domesticmouse/BufferedMult-SKiDL/prompts/README.md

# Conversation Prompt Archive for `skidl-test`

This directory contains detailed Markdown records capturing user prompts, Antigravity actions, tool executions, modified files, and timestamps across project conversations.

## Index of Conversations

| # | Title | Date / Time | Duration | Turns | Session Link | File |
| :--- | :--- | :--- | :---: | :---: | :---: | :--- |
| 01 | **I want to create a KiKad circuit using skidl. I'd like to buil...** | 2026-10-21 10:46 | 0:26:01 | 5 | `a742ea3b` [↗](conversation://a742ea3b-74c5-468e-a215-c797a4e4c2e3) | [01-i-want-to-create-a-kikad.md](./01-i-want-to-create-a-kikad.md) |
| 02 | **What is required to turn the @[buffered_multiple_bom.xml] into...** | 2026-10-21 11:16 | 0:19:49 | 4 | `af8a35a1` [↗](conversation://af8a35a1-3b6d-492d-a452-7a1e5ba92e80) | [02-what-is-required-to-turn-the.md](./02-what-is-required-to-turn-the.md) |
| 03 | **Please investigate whether JLCPCB has a IDC 2x5 socket availab...** | 2026-10-21 11:35 | 0:06:23 | 2 | `48d9d675` [↗](conversation://48d9d675-2952-4372-af7c-8b1982e387b5) | [03-please-investigate-whether-jlcpcb-has-a.md](./03-please-investigate-whether-jlcpcb-has-a.md) |
| 04 | **How do I layout this PCB in KiCad?** | 2026-10-21 11:44 | 0:36:38 | 3 | `ffb5d563` [↗](conversation://ffb5d563-22b9-4b88-94b1-c5f2bf82ae1d) | [04-how-do-i-layout-this-pcb.md](./04-how-do-i-layout-this-pcb.md) |
| 05 | **Please convert the Eurorack Power connector and bulk capacitor...** | 2026-10-21 12:03 | 0:09:54 | 2 | `15b14db8` [↗](conversation://15b14db8-7712-4b76-9b20-2e3bdbb96513) | [05-please-convert-the-eurorack-power-connector.md](./05-please-convert-the-eurorack-power-connector.md) |
| 06 | **Please update README.md. ** | 2026-10-21 13:20 | 0:01:45 | 2 | `3e06c8ae` [↗](conversation://3e06c8ae-e7f2-4f84-8cf3-1097a7c6791e) | [06-please-update-readmemd-add-a-link.md](./06-please-update-readmemd-add-a-link.md) |
| 07 | **Please review this circuit** | 2026-10-21 19:13 | 0:51:26 | 2 | `48d0b214` [↗](conversation://48d0b214-1fc2-4b9d-b364-0b4bdbb5ccb9) | [07-please-review-this-circuit.md](./07-please-review-this-circuit.md) |
| 08 | **Please check JLCPCB parts for TL074H SOIC** | 2026-10-21 20:03 | 0:10:37 | 3 | `04d450e8` [↗](conversation://04d450e8-f31b-45f6-a022-22b20fb043ac) | [08-please-check-jlcpcb-parts-for-tl074h.md](./08-please-check-jlcpcb-parts-for-tl074h.md) |
| 09 | **Please re-review the circuit, starting with @[DESIGN_REVIEW.md]** | 2026-10-21 20:15 | 0:28:12 | 5 | `2db85ec4` [↗](conversation://2db85ec4-f98f-4e91-9ac5-2ce34bc1bfed) | [09-please-re-review-the-circuit-starting-with.md](./09-please-re-review-the-circuit-starting-with.md) |
| 10 | **Please re-review the circuit, starting with @[/Users/brett/tmp...** | 2026-10-21 20:45 | 0:02:21 | 1 | `d98b5e5b` [↗](conversation://d98b5e5b-7830-4593-824d-9331d7db3262) | [10-please-re-review-the-circuit-starting-with.md](./10-please-re-review-the-circuit-starting-with.md) |
| 11 | **Can you please plan out how to build a eurorack front panel in...** | 2026-10-21 21:06 | 0:35:36 | 6 | `8dd2dc81` [↗](conversation://8dd2dc81-2770-4b0c-b64c-c19b7749be07) | [11-can-you-please-plan-out-how.md](./11-can-you-please-plan-out-how.md) |
| 12 | **Please update the README file** | 2026-10-21 22:14 | 0:01:17 | 1 | `c51f3164` [↗](conversation://c51f3164-342c-4dc3-85b9-59a051bba4fe) | [12-please-update-the-readme-file.md](./12-please-update-the-readme-file.md) |
| 13 | **/agy-brain-explorer Please list all of the conversations in th...** | 2026-10-21 22:27 | 0:09:37 | 3 | `b35c6fdb` [↗](conversation://b35c6fdb-13cd-4e95-881c-4535a604e93c) | [13-please-list-all-of-the-conversations.md](./13-please-list-all-of-the-conversations.md) |
