domesticmouse/BufferedMult-SKiDL/prompts/01-i-want-to-create-a-kikad.md

# Conversation 01: I want to create a KiKad circuit using skidl. I'd like to buil...

- **Session ID**: `a742ea3b-74c5-468e-a215-c797a4e4c2e3` [↗](conversation://a742ea3b-74c5-468e-a215-c797a4e4c2e3)
- **Start Time**: 2026-10-21 10:46:40 AEDT (`2026-10-20 23:46:40 UTC`)
- **End Time**: 2026-10-21 11:12:41 AEDT (`2026-10-21 00:12:41 UTC`)
- **Duration**: 0:26:01
- **Model**: Gemini 4 Argon (Medium)
- **Workspace**: [`/Users/brett/tmp/skidl-test`](file:///Users/brett/tmp/skidl-test)
- **Project**: `skidl-test`

---

## Conversation Turns

### Turn 1: I want to create a KiKad circuit using skidl. I'd like to...

- **Timestamp**: 2026-10-21 10:46:40 AEDT (`2026-10-20 23:46:40 UTC`)
- **Turn Duration**: 2026-10-21 10:50:50 AEDT (`2026-10-20 23:50:50 UTC`)

#### User Prompt

```text
I want to create a KiKad circuit using skidl. I'd like to build a Eurorack Buffered Multiple.
```

#### Antigravity Actions & Summary

Recreating the virtual environment with Python 3.14 so prebuilt binary wheels (such as `h5py`) can be used without compiling from source.

**Key Operations Executed:**

- `read_file`: [`SKILL.md`](file:///Users/brett/tmp/skidl-test/.agents/skills/skidl/SKILL.md)
- `ask_question`: Interactive user selection modal
- `run_command`: `ls -la && which python3`
- `run_command`: `find /Users/brett -maxdepth 3 -name "*venv*" 2>/dev/null; python3 -c "import skidl; pri...`
- `run_command`: `which uv pipx conda pyenv 2>/dev/null || true; /Applications/KiCad/KiCad.app/Contents/F...`
- `run_command`: `/Applications/KiCad/KiCad.app/Contents/MacOS/kicad-cli --version 2>/dev/null || true; u...`
- `run_command`: `ls -la /Users/brett/tmp 2>/dev/null || true; find /Users/brett/.cache/uv -name "*skidl*...`
- `run_command`: `pip3 list 2>/dev/null || true; uv cache dir 2>/dev/null || true`
- `run_command`: `uv venv .venv`
- `run_command`: `uv pip install skidl`
- `read_file`: [`advanced_patterns.md`](file:///Users/brett/tmp/skidl-test/.agents/skills/skidl/references/advanced_patterns.md)
- `run_command`: `uv python list --only-installed`
- `run_command`: `uv venv --python 3.14 .venv`

---

### Turn 2: That was taking too long. Please re-try

- **Timestamp**: 2026-10-21 10:57:31 AEDT (`2026-10-20 23:57:31 UTC`)
- **Turn Duration**: 2026-10-21 11:07:11 AEDT (`2026-10-21 00:07:11 UTC`)

#### User Prompt

```text
That was taking too long. Please re-try
```

#### Antigravity Actions & Summary

I have created and verified the SKiDL circuit for your **Eurorack Buffered Multiple (Dual 1-to-3, Normalized to 1-to-6, SMD)** in [buffered_multiple.py](file:///Users/brett/tmp/skidl-test/buffered_multiple.py). 1. **Power Supply & Protection ([`eurorack_power`](file:///Users/brett/tmp/skidl-test/buffered_multiple.py#L46-L109))**:
   - **Header (`J1`)**: 10-pin (2x5) Eurorack IDC power header (`Connector_IDC:IDC-Header_2x05_P2.54mm_Vertical`) with pins `1–2` on `-12V`, `3–8` on `GND`, and `9–10` on `+12V`.
   - **Reverse-Polarity Protection (`D1`, `D2`)**: `1N5819` / `SS14` Schottky diodes i...

**Key Operations Executed:**

- `run_command`: `uv venv --clear --python 3.14 .venv`
- `run_command`: `uv pip install skidl`
- `run_command`: `.venv/bin/python -c '`
- `read_file`: [`config_.py`](file:///Users/brett/tmp/skidl-test/.venv/lib/python3.14/site-packages/skidl/config_.py)
- `write_file`: [`sitecustomize.py`](file:///Users/brett/tmp/skidl-test/.venv/lib/python3.14/site-packages/sitecustomize.py)
- `write_file`: [`inspect_parts.py`](file:///Users/brett/.gemini/antigravity/brain/a742ea3b-74c5-468e-a215-c797a4e4c2e3/scratch/inspect_parts.py)
- `run_command`: `.venv/bin/python /Users/brett/.gemini/antigravity/brain/a742ea3b-74c5-468e-a215-c797a4e...`
- `run_command`: `ls /Applications/KiCad/KiCad.app/Contents/SharedSupport/footprints/Connector_Audio.pret...`
- `write_file`: [`buffered_multiple.py`](file:///Users/brett/tmp/skidl-test/buffered_multiple.py)
- `run_command`: `.venv/bin/python buffered_multiple.py`
- `edit_file`: [`buffered_multiple.py`](file:///Users/brett/tmp/skidl-test/buffered_multiple.py)
- `run_command`: `ls -la`
- `run_command`: `rm -f inspect_parts.erc inspect_parts.log skidl_REPL.erc skidl_REPL.log && .venv/bin/py...`

---

### Turn 3: Please run `ruff` for linting and formatting the python c...

- **Timestamp**: 2026-10-21 11:06:52 AEDT (`2026-10-21 00:06:52 UTC`)
- **Turn Duration**: 2026-10-21 11:08:46 AEDT (`2026-10-21 00:08:46 UTC`)

#### User Prompt

```text
Please run `ruff` for linting and formatting the python code.
```

#### Antigravity Actions & Summary

`ruff` linting and formatting have been applied across the workspace: - Replaced the wildcard `from skidl import *` in [buffered_multiple.py](file:///Users/brett/tmp/skidl-test/buffered_multiple.py#L41-L53) with explicit imports and set executable permissions (`chmod +x`) to satisfy `EXE001`.
- Fixed and formatted the auto-generated SKiDL backup library [buffered_multiple_sklib.py](file:///Users/brett/tmp/skidl-test/buffered_multiple_sklib.py).
- Verified both `ruff check .` (`All checks passed!`) and `ruff format --check .` (`4 files already formatted`) exit cleanly with 0 issues.

**Key Operations Executed:**

- `run_command`: `which ruff || .venv/bin/ruff --version 2>/dev/null || uv tool run ruff --version 2>/dev...`
- `run_command`: `ruff check buffered_multiple.py && ruff format --check buffered_multiple.py`
- `run_command`: `chmod +x buffered_multiple.py && ruff format buffered_multiple.py && ruff check buffere...`
- `run_command`: `ruff check . && ruff format --check .`
- `read_file`: [`buffered_multiple.py`](file:///Users/brett/tmp/skidl-test/buffered_multiple.py)
- `edit_file`: [`buffered_multiple.py`](file:///Users/brett/tmp/skidl-test/buffered_multiple.py)
- `run_command`: `ruff check --fix . && ruff format . && ruff check . && ruff format --check .`

---

### Turn 4: /agy-customizations please create / update skills based o...

- **Timestamp**: 2026-10-21 11:09:32 AEDT (`2026-10-21 00:09:32 UTC`)
- **Turn Duration**: 2026-10-21 11:11:26 AEDT (`2026-10-21 00:11:26 UTC`)

#### User Prompt

```text
/agy-customizations please create / update skills based on what you learned in this conversation
```

#### Antigravity Actions & Summary

I have updated the workspace `skidl` skill ([SKILL.md](file:///Users/brett/tmp/skidl-test/.agents/skills/skidl/SKILL.md) and [advanced_patterns.md](file:///Users/brett/tmp/skidl-test/.agents/skills/skidl/references/advanced_patterns.md)) with the lessons learned from this session: 1. **Virtual Environment & Prebuilt Wheels ([SKILL.md](file:///Users/brett/tmp/skidl-test/.agents/skills/skidl/SKILL.md#L17-L21))**:
   - Documented using Python 3.12–3.14 (`uv venv --clear --python 3.14 .venv`) to ensure prebuilt `h5py` wheels are available (avoiding source compilation failures on Python 3.15 whe...

**Key Operations Executed:**

- `read_file`: [`SKILL.md`](file:///Users/brett/.gemini/antigravity/builtin/skills/agy-customizations/SKILL.md)
- `read_file`: [`skills.md`](file:///Users/brett/.gemini/antigravity/builtin/skills/agy-customizations/docs/skills.md)
- `read_file`: [`SKILL.md`](file:///Users/brett/tmp/skidl-test/.agents/skills/skidl/SKILL.md)
- `edit_file`: [`SKILL.md`](file:///Users/brett/tmp/skidl-test/.agents/skills/skidl/SKILL.md)
- `edit_file`: [`advanced_patterns.md`](file:///Users/brett/tmp/skidl-test/.agents/skills/skidl/references/advanced_patterns.md)

---

### Turn 5: Please create a README.md for this project

- **Timestamp**: 2026-10-21 11:12:11 AEDT (`2026-10-21 00:12:11 UTC`)
- **Turn Duration**: 2026-10-21 11:12:41 AEDT (`2026-10-21 00:12:41 UTC`)

#### User Prompt

```text
Please create a README.md for this project
```

#### Antigravity Actions & Summary

I have created [README.md](file:///Users/brett/tmp/skidl-test/README.md) for the project. It includes: - **Features & Architecture**: Explanation of the Dual 1-to-3 / cascaded 1-to-6 normalization, op-amp buffering topology, and Eurorack power protection, along with a Mermaid signal-flow diagram.
- **Bill of Materials (BOM)**: Full table of quantities, component values, KiCad 10 symbols, and SMD/THT footprints.
- **Getting Started**: Setup instructions using `uv`, running [buffered_multiple.py](file:///Users/brett/tmp/skidl-test/buffered_multiple.py), and linting/formatting with `ruff`.
- *...

**Key Operations Executed:**

- `write_file`: [`README.md`](file:///Users/brett/tmp/skidl-test/README.md)

---

## Key Files Created / Modified

- [`sitecustomize.py`](file:///Users/brett/tmp/skidl-test/.venv/lib/python3.14/site-packages/sitecustomize.py) - `/Users/brett/tmp/skidl-test/.venv/lib/python3.14/site-packages/sitecustomize.py`
- [`inspect_parts.py`](file:///Users/brett/.gemini/antigravity/brain/a742ea3b-74c5-468e-a215-c797a4e4c2e3/scratch/inspect_parts.py) - `/Users/brett/.gemini/antigravity/brain/a742ea3b-74c5-468e-a215-c797a4e4c2e3/scratch/inspect_parts.py`
- [`buffered_multiple.py`](file:///Users/brett/tmp/skidl-test/buffered_multiple.py) - `/Users/brett/tmp/skidl-test/buffered_multiple.py`
- [`SKILL.md`](file:///Users/brett/tmp/skidl-test/.agents/skills/skidl/SKILL.md) - `/Users/brett/tmp/skidl-test/.agents/skills/skidl/SKILL.md`
- [`advanced_patterns.md`](file:///Users/brett/tmp/skidl-test/.agents/skills/skidl/references/advanced_patterns.md) - `/Users/brett/tmp/skidl-test/.agents/skills/skidl/references/advanced_patterns.md`
- [`README.md`](file:///Users/brett/tmp/skidl-test/README.md) - `/Users/brett/tmp/skidl-test/README.md`
