domesticmouse/BufferedMult-SKiDL/prompts/03-please-investigate-whether-jlcpcb-has-a.md

# Conversation 03: Please investigate whether JLCPCB has a IDC 2x5 socket availab...

- **Session ID**: `48d9d675-2952-4372-af7c-8b1982e387b5` [↗](conversation://48d9d675-2952-4372-af7c-8b1982e387b5)
- **Start Time**: 2026-10-21 11:35:57 AEDT (`2026-10-21 00:35:57 UTC`)
- **End Time**: 2026-10-21 11:42:20 AEDT (`2026-10-21 00:42:20 UTC`)
- **Duration**: 0:06:23
- **Model**: Gemini 4 Argon (Medium)
- **Workspace**: [`/Users/brett/tmp/skidl-test`](file:///Users/brett/tmp/skidl-test)
- **Project**: `skidl-test`

---

## Conversation Turns

### Turn 1: Please investigate whether JLCPCB has a IDC 2x5 socket av...

- **Timestamp**: 2026-10-21 11:35:57 AEDT (`2026-10-21 00:35:57 UTC`)
- **Turn Duration**: 2026-10-21 11:37:31 AEDT (`2026-10-21 00:37:31 UTC`)

#### User Prompt

```text
Please investigate whether JLCPCB has a IDC 2x5 socket available as a SMD part, and if they do, what is the cost.
```

#### Antigravity Actions & Summary

Yes, JLCPCB stocks several SMD 2x5 (10-pin) connectors in their live catalog (queried via [jlcpcb_search.py](file:///Users/brett/tmp/skidl-test/.agents/skills/skidl/scripts/jlcpcb_search.py)). All 2x5 SMD IDC/header parts on JLCPCB are classified as **Extended Parts**, meaning they carry a one-time **~\$3.00 feeder loading fee** per order in addition to the per-unit component cost.

**Key Operations Executed:**

- `read_file`: [`SKILL.md`](file:///Users/brett/tmp/skidl-test/.agents/skills/skidl/SKILL.md)
- `read_file`: [`jlcpcb_bom.md`](file:///Users/brett/tmp/skidl-test/.agents/skills/skidl/references/jlcpcb_bom.md)
- `read_file`: [`jlcpcb_search.py`](file:///Users/brett/tmp/skidl-test/.agents/skills/skidl/scripts/jlcpcb_search.py)
- `run_command`: `python3 .agents/skills/skidl/scripts/jlcpcb_search.py --in-stock-only --limit 15 "IDC 2...`
- `run_command`: `python3 .agents/skills/skidl/scripts/jlcpcb_search.py --in-stock-only --limit 30 "IDC C...`

---

### Turn 2: Please update the circuit to use C41376028 for the eurora...

- **Timestamp**: 2026-10-21 11:40:10 AEDT (`2026-10-21 00:40:10 UTC`)
- **Turn Duration**: 2026-10-21 11:42:20 AEDT (`2026-10-21 00:42:20 UTC`)

#### User Prompt

```text
Please update the circuit to use C41376028 for the eurorack power adapter
```

#### Antigravity Actions & Summary

I have updated the Eurorack power header in [`eurorack_power`](file:///Users/brett/tmp/skidl-test/buffered_multiple.py#L79-L96) to use the SMD 2x5 shrouded IDC connector (`C41376028`) and regenerated all output files:

**Key Operations Executed:**

- `run_command`: `ls -la /Users/brett/tmp/skidl-test`
- `read_file`: [`buffered_multiple.py`](file:///Users/brett/tmp/skidl-test/buffered_multiple.py)
- `read_file`: [`buffered_multiple_jlcpcb_bom.csv`](file:///Users/brett/tmp/skidl-test/buffered_multiple_jlcpcb_bom.csv)
- `read_file`: [`README.md`](file:///Users/brett/tmp/skidl-test/README.md)
- `run_command`: `.venv/bin/python -c '`
- `run_command`: `ls /Applications/KiCad/KiCad.app/Contents/SharedSupport/footprints/Connector_IDC.pretty...`
- `edit_file`: [`buffered_multiple.py`](file:///Users/brett/tmp/skidl-test/buffered_multiple.py)
- `edit_file`: [`README.md`](file:///Users/brett/tmp/skidl-test/README.md)
- `run_command`: `.venv/bin/python buffered_multiple.py && ruff check --fix . && ruff format .`

---

## Key Files Created / Modified

- [`buffered_multiple.py`](file:///Users/brett/tmp/skidl-test/buffered_multiple.py) - `/Users/brett/tmp/skidl-test/buffered_multiple.py`
- [`README.md`](file:///Users/brett/tmp/skidl-test/README.md) - `/Users/brett/tmp/skidl-test/README.md`
