domesticmouse/BufferedMult-SKiDL/prompts/04-how-do-i-layout-this-pcb.md

# Conversation 04: How do I layout this PCB in KiCad?

- **Session ID**: `ffb5d563-22b9-4b88-94b1-c5f2bf82ae1d` [↗](conversation://ffb5d563-22b9-4b88-94b1-c5f2bf82ae1d)
- **Start Time**: 2026-10-21 11:44:09 AEDT (`2026-10-21 00:44:09 UTC`)
- **End Time**: 2026-10-21 12:20:47 AEDT (`2026-10-21 01:20:47 UTC`)
- **Duration**: 0:36:38
- **Model**: Gemini 4 Argon (Medium)
- **Workspace**: [`/Users/brett/tmp/skidl-test`](file:///Users/brett/tmp/skidl-test)
- **Project**: `skidl-test`

---

## Conversation Turns

### Turn 1: How do I layout this PCB in KiCad?

- **Timestamp**: 2026-10-21 11:44:09 AEDT (`2026-10-21 00:44:09 UTC`)
- **Turn Duration**: 2026-10-21 11:44:38 AEDT (`2026-10-21 00:44:38 UTC`)

#### User Prompt

```text
How do I layout this PCB in KiCad?
```

#### Antigravity Actions & Summary

Here is the step-by-step workflow to lay out your Eurorack Buffered Multiple PCB in **KiCad 10** using [buffered_multiple.net](file:///Users/brett/tmp/skidl-test/buffered_multiple.net) (generated by [buffered_multiple.py](file:///Users/brett/tmp/skidl-test/buffered_multiple.py)). ---

**Key Operations Executed:**

- `read_file`: [`SKILL.md`](file:///Users/brett/tmp/skidl-test/.agents/skills/skidl/SKILL.md)
- `run_command`: `ls -la /Users/brett/tmp/skidl-test`
- `read_file`: [`README.md`](file:///Users/brett/tmp/skidl-test/README.md)
- `read_file`: [`buffered_multiple.py`](file:///Users/brett/tmp/skidl-test/buffered_multiple.py)
- `read_file`: [`buffered_multiple_jlcpcb_bom.csv`](file:///Users/brett/tmp/skidl-test/buffered_multiple_jlcpcb_bom.csv)
- `run_command`: `grep -E '\(comp \(ref|\(value|\(footprint' /Users/brett/tmp/skidl-test/buffered_multipl...`
- `read_file`: [`buffered_multiple.net`](file:///Users/brett/tmp/skidl-test/buffered_multiple.net)

---

### Turn 2: Please update this guide for the new parts and write to d...

- **Timestamp**: 2026-10-21 12:15:30 AEDT (`2026-10-21 01:15:30 UTC`)
- **Turn Duration**: 2026-10-21 12:16:49 AEDT (`2026-10-21 01:16:49 UTC`)

#### User Prompt

```text
Please update this guide for the new parts and write to disk as a markdown file
```

#### Antigravity Actions & Summary

I have updated the layout guide for the new through-hole power header (`J1`, `IDC-Header_2x05_P2.54mm_Vertical`) and radial bulk electrolytic capacitors (`C1`, `C2`, `CP_Radial_D5.0mm_P2.00mm` / `ECEA1EKS100`) and saved it to [PCB_LAYOUT_GUIDE.md](file:///Users/brett/tmp/skidl-test/PCB_LAYOUT_GUIDE.md) (and linked it from [README.md](file:///Users/brett/tmp/skidl-test/README.md#L102-L107)).

**Key Operations Executed:**

- `read_file`: [`buffered_multiple.py`](file:///Users/brett/tmp/skidl-test/buffered_multiple.py)
- `read_file`: [`README.md`](file:///Users/brett/tmp/skidl-test/README.md)
- `read_file`: [`buffered_multiple_jlcpcb_bom.csv`](file:///Users/brett/tmp/skidl-test/buffered_multiple_jlcpcb_bom.csv)
- `run_command`: `git status -s && git diff --stat`
- `write_file`: [`PCB_LAYOUT_GUIDE.md`](file:///Users/brett/tmp/skidl-test/PCB_LAYOUT_GUIDE.md)
- `edit_file`: [`README.md`](file:///Users/brett/tmp/skidl-test/README.md)

---

### Turn 3: Please update the layout guide to show the bulk capacitor...

- **Timestamp**: 2026-10-21 12:19:55 AEDT (`2026-10-21 01:19:55 UTC`)
- **Turn Duration**: 2026-10-21 12:20:47 AEDT (`2026-10-21 01:20:47 UTC`)

#### User Prompt

```text
Please update the layout guide to show the bulk capacitors as being front mounted. Everything else looks correct
```

#### Antigravity Actions & Summary

I have updated [PCB_LAYOUT_GUIDE.md](file:///Users/brett/tmp/skidl-test/PCB_LAYOUT_GUIDE.md) so the radial bulk electrolytic capacitors (`C1`, `C2`, `ECEA1EKS100`) are placed on the **front side (`F.Cu`)** alongside the Eurorack jacks (`J2`–`J9`), leaving only `J1` (`EURORACK_PWR_10PIN`) and the 16 SMD components on the back side (`B.Cu`).

**Key Operations Executed:**

- `read_file`: [`PCB_LAYOUT_GUIDE.md`](file:///Users/brett/tmp/skidl-test/PCB_LAYOUT_GUIDE.md)
- `edit_file`: [`PCB_LAYOUT_GUIDE.md`](file:///Users/brett/tmp/skidl-test/PCB_LAYOUT_GUIDE.md)

---

## Key Files Created / Modified

- [`PCB_LAYOUT_GUIDE.md`](file:///Users/brett/tmp/skidl-test/PCB_LAYOUT_GUIDE.md) - `/Users/brett/tmp/skidl-test/PCB_LAYOUT_GUIDE.md`
- [`README.md`](file:///Users/brett/tmp/skidl-test/README.md) - `/Users/brett/tmp/skidl-test/README.md`
