domesticmouse/BufferedMult-SKiDL/prompts/05-please-convert-the-eurorack-power-connector.md

# Conversation 05: Please convert the Eurorack Power connector and bulk capacitor...

- **Session ID**: `15b14db8-7712-4b76-9b20-2e3bdbb96513` [↗](conversation://15b14db8-7712-4b76-9b20-2e3bdbb96513)
- **Start Time**: 2026-10-21 12:03:53 AEDT (`2026-10-21 01:03:53 UTC`)
- **End Time**: 2026-10-21 12:13:47 AEDT (`2026-10-21 01:13:47 UTC`)
- **Duration**: 0:09:54
- **Model**: Gemini 4 Argon (Medium)
- **Workspace**: [`/Users/brett/tmp/skidl-test`](file:///Users/brett/tmp/skidl-test)
- **Project**: `skidl-test`

---

## Conversation Turns

### Turn 1: Please convert the Eurorack Power connector and bulk capa...

- **Timestamp**: 2026-10-21 12:03:53 AEDT (`2026-10-21 01:03:53 UTC`)
- **Turn Duration**: 2026-10-21 12:06:15 AEDT (`2026-10-21 01:06:15 UTC`)

#### User Prompt

```text
Please convert the Eurorack Power connector and bulk capacitors to through hole parts. I don't want them on the JLCPCB BOM.
```

#### Antigravity Actions & Summary

I have converted the Eurorack power connector (`J1`) and the two `10uF` bulk electrolytic capacitors (`C1`, `C2`) to through-hole footprints and excluded them from the JLCPCB BOM: 1. **Through-Hole Footprints & BOM Exclusion in [`eurorack_power`](file:///Users/brett/tmp/skidl-test/buffered_multiple.py#L74-L135)**:
   - **Power Connector (`J1`)**: Updated [`FP_PWR_HEADER_10P`](file:///Users/brett/tmp/skidl-test/buffered_multiple.py#L65) to `Connector_IDC:IDC-Header_2x05_P2.54mm_Vertical` and marked `JLCPCB_Class` as `"Manual THT (DNP for SMT)"`.
   - **Bulk Electrolytic Capacitors (`C1`, `C2...

**Key Operations Executed:**

- `read_file`: [`SKILL.md`](file:///Users/brett/tmp/skidl-test/.agents/skills/skidl/SKILL.md)
- `run_command`: `ls -la /Users/brett/tmp/skidl-test`
- `read_file`: [`buffered_multiple.py`](file:///Users/brett/tmp/skidl-test/buffered_multiple.py)
- `read_file`: [`README.md`](file:///Users/brett/tmp/skidl-test/README.md)
- `read_file`: [`buffered_multiple_jlcpcb_bom.csv`](file:///Users/brett/tmp/skidl-test/buffered_multiple_jlcpcb_bom.csv)
- `read_file`: [`jlcpcb_bom.md`](file:///Users/brett/tmp/skidl-test/.agents/skills/skidl/references/jlcpcb_bom.md)
- `run_command`: `git log -p -n 3`
- `run_command`: `.venv/bin/python -c '`
- `run_command`: `ls /Applications/KiCad/KiCad.app/Contents/SharedSupport/footprints/Connector_IDC.pretty...`
- `run_command`: `git log -p buffered_multiple.py`
- `edit_file`: [`buffered_multiple.py`](file:///Users/brett/tmp/skidl-test/buffered_multiple.py)
- `edit_file`: [`README.md`](file:///Users/brett/tmp/skidl-test/README.md)
- `run_command`: `.venv/bin/python buffered_multiple.py && ruff check --fix . && ruff format .`
- `run_command`: `git status -s && ruff check .`

---

### Turn 2: Please confirm for the bulk capacitors, the footprint is ...

- **Timestamp**: 2026-10-21 12:12:10 AEDT (`2026-10-21 01:12:10 UTC`)
- **Turn Duration**: 2026-10-21 12:13:47 AEDT (`2026-10-21 01:13:47 UTC`)

#### User Prompt

```text
Please confirm for the bulk capacitors, the footprint is usable with https://www.lcsc.com/product-detail/C713347.html
```

#### Antigravity Actions & Summary

Good catch checking the exact part! **`C713347`** is the **Panasonic `ECEA1EKS100`** ($10\,\mu\text{F}$, $25\,\text{V}$, KS Series miniature radial electrolytic capacitor): | Parameter | Panasonic `ECEA1EKS100` (`C713347`) | KiCad `Capacitor_THT:CP_Radial_D5.0mm_P2.00mm` |
| :--- | :--- | :--- |
| **Body Diameter ($\emptyset D$)** | $5.0\,\text{mm}$ ($\times 5.0\,\text{mm}$ height) | $5.0\,\text{mm}$ |
| **Lead Spacing / Pitch ($F$)** | **$2.0\,\text{mm}$** (straight leads) | **$2.00\,\text{mm}$** |
| **Lead Diameter ($\emptyset d$) / Drill** | $0.5\,\text{mm}$ lead | $0.8\,\text{mm}$ drill...

**Key Operations Executed:**

- `search_web`: *""C713347" lcsc capacitor"*
- `search_web`: *""ECEA1EKS100" "lead spacing" OR "pitch" OR "2.0mm" OR "2.5mm""*
- `read_file`: [`CP_Radial_D5.0mm_P2.00mm.kicad_mod`](file:///Applications/KiCad/KiCad.app/Contents/SharedSupport/footprints/Capacitor_THT.pretty/CP_Radial_D5.0mm_P2.00mm.kicad_mod)
- `read_file`: [`CP_Radial_D5.0mm_P2.50mm.kicad_mod`](file:///Applications/KiCad/KiCad.app/Contents/SharedSupport/footprints/Capacitor_THT.pretty/CP_Radial_D5.0mm_P2.50mm.kicad_mod)
- `search_web`: *""ECEA1EKS100" "2.0" OR "2.5" panasonic KS series lead spacing"*
- `edit_file`: [`buffered_multiple.py`](file:///Users/brett/tmp/skidl-test/buffered_multiple.py)
- `edit_file`: [`README.md`](file:///Users/brett/tmp/skidl-test/README.md)
- `run_command`: `.venv/bin/python buffered_multiple.py && ruff check --fix . && ruff format .`

---

## Key Files Created / Modified

- [`buffered_multiple.py`](file:///Users/brett/tmp/skidl-test/buffered_multiple.py) - `/Users/brett/tmp/skidl-test/buffered_multiple.py`
- [`README.md`](file:///Users/brett/tmp/skidl-test/README.md) - `/Users/brett/tmp/skidl-test/README.md`
