domesticmouse/BufferedMult-SKiDL/prompts/06-please-update-readmemd-add-a-link.md

# Conversation 06: Please update README.md. 

- **Session ID**: `3e06c8ae-e7f2-4f84-8cf3-1097a7c6791e` [↗](conversation://3e06c8ae-e7f2-4f84-8cf3-1097a7c6791e)
- **Start Time**: 2026-10-21 13:20:35 AEDT (`2026-10-21 02:20:35 UTC`)
- **End Time**: 2026-10-21 13:22:20 AEDT (`2026-10-21 02:22:20 UTC`)
- **Duration**: 0:01:45
- **Model**: Gemini 4 Argon (Medium)
- **Workspace**: [`/Users/brett/tmp/skidl-test`](file:///Users/brett/tmp/skidl-test)
- **Project**: `skidl-test`

---

## Conversation Turns

### Turn 1: Please update README.md. 

- **Timestamp**: 2026-10-21 13:20:35 AEDT (`2026-10-21 02:20:35 UTC`)
- **Turn Duration**: 2026-10-21 13:21:16 AEDT (`2026-10-21 02:21:16 UTC`)

#### User Prompt

```text
Please update README.md. 
Add a link to https://github.com/domesticmouse/Buffered-Mult. This is a re-implementation of that circuit, without the LED feedback, using SKiDL.
At the bottom, reference the LICENSE, and add that this is not an official Google product.
```

#### Antigravity Actions & Summary

Updated [README.md](file:///Users/brett/tmp/skidl-test/README.md) with:
- A reference and link to [domesticmouse/Buffered-Mult](https://github.com/domesticmouse/Buffered-Mult) in the introduction, noting that this project is a SKiDL re-implementation without the LED feedback circuitry.
- A **License** section at the bottom referencing [LICENSE.txt](file:///Users/brett/tmp/skidl-test/LICENSE.txt) (Apache 2.0) and the disclaimer that this is not an official Google product.

**Key Operations Executed:**

- `read_file`: [`README.md`](file:///Users/brett/tmp/skidl-test/README.md)
- `read_file`: [`LICENSE`](file:///Users/brett/tmp/skidl-test/LICENSE)
- `run_command`: `ls -la /Users/brett/tmp/skidl-test`
- `read_file`: [`LICENSE.txt`](file:///Users/brett/tmp/skidl-test/LICENSE.txt)
- `edit_file`: [`README.md`](file:///Users/brett/tmp/skidl-test/README.md)

---

### Turn 2: Add a note that there is now a PCB in this directory. Del...

- **Timestamp**: 2026-10-21 13:22:01 AEDT (`2026-10-21 02:22:01 UTC`)
- **Turn Duration**: 2026-10-21 13:22:20 AEDT (`2026-10-21 02:22:20 UTC`)

#### User Prompt

```text
Add a note that there is now a PCB in this directory. Delete the instructions for creating a PCB.
```

#### Antigravity Actions & Summary

Updated [README.md](file:///Users/brett/tmp/skidl-test/README.md) to remove the PCB creation instructions and note the included KiCad 10 PCB files ([BufferedMult.kicad_pro](file:///Users/brett/tmp/skidl-test/BufferedMult.kicad_pro) and [BufferedMult.kicad_pcb](file:///Users/brett/tmp/skidl-test/BufferedMult.kicad_pcb)). Would you also like me to delete [PCB_LAYOUT_GUIDE.md](file:///Users/brett/tmp/skidl-test/PCB_LAYOUT_GUIDE.md)?

**Key Operations Executed:**

- `read_file`: [`README.md`](file:///Users/brett/tmp/skidl-test/README.md)
- `run_command`: `git status`
- `edit_file`: [`README.md`](file:///Users/brett/tmp/skidl-test/README.md)

---

## Key Files Created / Modified

- [`README.md`](file:///Users/brett/tmp/skidl-test/README.md) - `/Users/brett/tmp/skidl-test/README.md`
