domesticmouse/BufferedMult-SKiDL/prompts/07-please-review-this-circuit.md

# Conversation 07: Please review this circuit

- **Session ID**: `48d0b214-1fc2-4b9d-b364-0b4bdbb5ccb9` [↗](conversation://48d0b214-1fc2-4b9d-b364-0b4bdbb5ccb9)
- **Start Time**: 2026-10-21 19:13:12 AEDT (`2026-10-21 08:13:12 UTC`)
- **End Time**: 2026-10-21 20:04:38 AEDT (`2026-10-21 09:04:38 UTC`)
- **Duration**: 0:51:26
- **Model**: Gemini 4 Argon (Medium)
- **Workspace**: [`/Users/brett/tmp/skidl-test`](file:///Users/brett/tmp/skidl-test)
- **Project**: `skidl-test`

---

## Conversation Turns

### Turn 1: Please review this circuit

- **Timestamp**: 2026-10-21 19:13:12 AEDT (`2026-10-21 08:13:12 UTC`)
- **Turn Duration**: 2026-10-21 19:17:06 AEDT (`2026-10-21 08:17:06 UTC`)

#### User Prompt

```text
Please review this circuit
```

#### Antigravity Actions & Summary

**Verdict: NOT READY FOR FABRICATION (2 Critical PCB Layout / DRC Open-Circuit Bugs)** While the SKiDL circuit definition ([buffered_multiple.py](file:///Users/brett/tmp/skidl-test/buffered_multiple.py)) and netlist ([buffered_multiple.net](file:///Users/brett/tmp/skidl-test/buffered_multiple.net)) are electrically sound and pass ERC with zero errors, the routed PCB ([BufferedMult.kicad_pcb](file:///Users/brett/tmp/skidl-test/BufferedMult.kicad_pcb)) and exported manufacturing archive ([production/BufferedMult.zip](file:///Users/brett/tmp/skidl-test/production/BufferedMult.zip)) contain **t...

**Key Operations Executed:**

- `run_command`: `ls -la /Users/brett/tmp/skidl-test`
- `read_file`: [`SKILL.md`](file:///Users/brett/tmp/skidl-test/.agents/skills/skidl/SKILL.md)
- `read_file`: [`SKILL.md`](file:///Users/brett/tmp/skidl-test/.agents/skills/kicad/SKILL.md)
- `read_file`: [`buffered_multiple.py`](file:///Users/brett/tmp/skidl-test/buffered_multiple.py)
- `read_file`: [`README.md`](file:///Users/brett/tmp/skidl-test/README.md)
- `read_file`: [`PCB_LAYOUT_GUIDE.md`](file:///Users/brett/tmp/skidl-test/PCB_LAYOUT_GUIDE.md)
- `read_file`: [`report-generation.md`](file:///Users/brett/tmp/skidl-test/.agents/skills/kicad/references/report-generation.md)
- `read_file`: [`SKILL.md`](file:///Users/brett/tmp/skidl-test/.agents/skills/emc/SKILL.md)
- `read_file`: [`SKILL.md`](file:///Users/brett/tmp/skidl-test/.agents/skills/spice/SKILL.md)
- `run_command`: `ls -la /Users/brett/tmp/skidl-test/production`
- `read_file`: [`BufferedMult.kicad_pro`](file:///Users/brett/tmp/skidl-test/BufferedMult.kicad_pro)
- `read_file`: [`buffered_multiple.erc`](file:///Users/brett/tmp/skidl-test/buffered_multiple.erc)
- `read_file`: [`buffered_multiple.log`](file:///Users/brett/tmp/skidl-test/buffered_multiple.log)
- `read_file`: [`buffered_multiple_jlcpcb_bom.csv`](file:///Users/brett/tmp/skidl-test/buffered_multiple_jlcpcb_bom.csv)
- `read_file`: [`bom.csv`](file:///Users/brett/tmp/skidl-test/production/bom.csv)
- `read_file`: [`positions.csv`](file:///Users/brett/tmp/skidl-test/production/positions.csv)
- `run_command`: `which ngspice ltspice xyce kicad-cli`
- `run_command`: `python3 .agents/skills/kicad/scripts/analyze_pcb.py BufferedMult.kicad_pcb --full --pro...`
- `run_command`: `mkdir -p /tmp/gerbers_check && unzip -o production/BufferedMult.zip -d /tmp/gerbers_che...`
- `read_file`: [`buffered_multiple.net`](file:///Users/brett/tmp/skidl-test/buffered_multiple.net)
- `read_file`: [`fabrication-toolkit-options.json`](file:///Users/brett/tmp/skidl-test/fabrication-toolkit-options.json)
- `run_command`: `python3 .agents/skills/kicad/scripts/analyze_schematic.py --help`
- `run_command`: `/Applications/KiCad/KiCad.app/Contents/MacOS/kicad-cli pcb drc --output /tmp/drc_report...`
- `run_command`: `python3 .agents/skills/kicad/scripts/analyze_pcb.py BufferedMult.kicad_pcb --text`
- `run_command`: `python3 .agents/skills/kicad/scripts/analyze_gerbers.py /tmp/gerbers_check --text`
- `run_command`: `python3 -c "import json; d=json.load(open('/tmp/drc_report.json')); print('Unconnected:...`
- `run_command`: `python3 -c "import json, glob; p=sorted(glob.glob('analysis/*/pcb.json'))[-1]; d=json.l...`
- `run_command`: `python3 .agents/skills/emc/scripts/analyze_emc.py --pcb analysis/2026-10-21_1914/pcb.js...`
- `run_command`: `python3 -c "import re; s=open('BufferedMult.kicad_pcb').read(); print('\n'.join(re.find...`
- `run_command`: `python3 -c "import json, glob; p=sorted(glob.glob('analysis/*/gerber.json'))[-1]; d=jso...`
- `run_command`: `rm -rf /Users/brett/tmp/skidl-test/analysis /tmp/gerbers_check /tmp/drc_report.json && ...`
- `run_command`: `rm -rf .agents/skills/datasheets/datasheet_types/__pycache__ .agents/skills/datasheets/...`

---

### Turn 2: Please write this review to disk

- **Timestamp**: 2026-10-21 20:03:56 AEDT (`2026-10-21 09:03:56 UTC`)
- **Turn Duration**: 2026-10-21 20:04:38 AEDT (`2026-10-21 09:04:38 UTC`)

#### User Prompt

```text
Please write this review to disk
```

#### Antigravity Actions & Summary

I have written the design review to [DESIGN_REVIEW.md](file:///Users/brett/tmp/skidl-test/DESIGN_REVIEW.md).

**Key Operations Executed:**

- `write_file`: [`DESIGN_REVIEW.md`](file:///Users/brett/tmp/skidl-test/DESIGN_REVIEW.md)

---

## Key Files Created / Modified

- [`DESIGN_REVIEW.md`](file:///Users/brett/tmp/skidl-test/DESIGN_REVIEW.md) - `/Users/brett/tmp/skidl-test/DESIGN_REVIEW.md`
