domesticmouse/BufferedMult-SKiDL/prompts/09-please-re-review-the-circuit-starting-with.md

# Conversation 09: Please re-review the circuit, starting with @[DESIGN_REVIEW.md]

- **Session ID**: `2db85ec4-f98f-4e91-9ac5-2ce34bc1bfed` [↗](conversation://2db85ec4-f98f-4e91-9ac5-2ce34bc1bfed)
- **Start Time**: 2026-10-21 20:15:19 AEDT (`2026-10-21 09:15:19 UTC`)
- **End Time**: 2026-10-21 20:43:31 AEDT (`2026-10-21 09:43:31 UTC`)
- **Duration**: 0:28:12
- **Model**: Gemini 4 Argon (Medium)
- **Workspace**: [`/Users/brett/tmp/skidl-test`](file:///Users/brett/tmp/skidl-test)
- **Project**: `skidl-test`

---

## Conversation Turns

### Turn 1: Please re-review the circuit, starting with @[DESIGN_REVI...

- **Timestamp**: 2026-10-21 20:15:19 AEDT (`2026-10-21 09:15:19 UTC`)
- **Turn Duration**: 2026-10-21 20:16:57 AEDT (`2026-10-21 09:16:57 UTC`)

#### User Prompt

```text
Please re-review the circuit, starting with @[DESIGN_REVIEW.md]
```

#### Antigravity Actions & Summary

thought
WHOA!! Look at what we just discovered!
Let's carefully

**Key Operations Executed:**

- `read_file`: [`DESIGN_REVIEW.md`](file:///Users/brett/tmp/skidl-test/DESIGN_REVIEW.md)
- `read_file`: [`SKILL.md`](file:///Users/brett/tmp/skidl-test/.agents/skills/skidl/SKILL.md)
- `read_file`: [`SKILL.md`](file:///Users/brett/tmp/skidl-test/.agents/skills/kicad/SKILL.md)
- `read_file`: [`buffered_multiple.py`](file:///Users/brett/tmp/skidl-test/buffered_multiple.py)
- `read_file`: [`report-generation.md`](file:///Users/brett/tmp/skidl-test/.agents/skills/kicad/references/report-generation.md)
- `run_command`: `git status -s && ls -la && ls -la production/`
- `run_command`: `git log -n 5 --stat && git show --stat HEAD`
- `run_command`: `/Applications/KiCad/KiCad.app/Contents/MacOS/kicad-cli pcb drc --output /tmp/drc_report...`
- `run_command`: `python3 .agents/skills/kicad/scripts/analyze_pcb.py BufferedMult.kicad_pcb --full --pro...`
- `run_command`: `.venv/bin/python buffered_multiple.py && cat buffered_multiple.erc && cat buffered_mult...`
- `run_command`: `python3 -c '`

---

### Turn 2: WHOA?

- **Timestamp**: 2026-10-21 20:18:10 AEDT (`2026-10-21 09:18:10 UTC`)
- **Turn Duration**: 2026-10-21 20:19:41 AEDT (`2026-10-21 09:19:41 UTC`)

#### User Prompt

```text
WHOA?
```

#### Antigravity Actions & Summary

Created At: 2026-10-21T20:19:41+11:00
Completed At: 2026-10-21T20:19:43+11:00
Created file.

**Key Operations Executed:**

- `run_command`: `python3 -c '`
- `write_file`: [`DESIGN_REVIEW.md`](file:///Users/brett/tmp/skidl-test/DESIGN_REVIEW.md)

---

### Turn 3: GERBERs haven't been updated

- **Timestamp**: 2026-10-21 20:19:01 AEDT (`2026-10-21 09:19:01 UTC`)
- **Turn Duration**: 2026-10-21 20:19:59 AEDT (`2026-10-21 09:19:59 UTC`)

#### User Prompt

```text
GERBERs haven't been updated
```

#### Antigravity Actions & Summary

Haha — apologies for getting cut off mid-thought! The reaction was from seeing `kicad-cli pcb drc` report **`0 unconnected items`** (both critical open-circuit bugs from the first review are completely fixed), alongside **6 new DRC clearance violations** caused by widening the `-12V` trace from `0.2 mm` to `0.5 mm`. I have updated [DESIGN_REVIEW.md](file:///Users/brett/tmp/skidl-test/DESIGN_REVIEW.md) to reflect the current state of [buffered_multiple.py](file:///Users/brett/tmp/skidl-test/buffered_multiple.py) and [BufferedMult.kicad_pcb](file:///Users/brett/tmp/skidl-test/BufferedMult.kic...

**Key Operations Executed:**

- `edit_file`: [`DESIGN_REVIEW.md`](file:///Users/brett/tmp/skidl-test/DESIGN_REVIEW.md)

---

### Turn 4: Plesae re-check DRC clearance violations

- **Timestamp**: 2026-10-21 20:36:33 AEDT (`2026-10-21 09:36:33 UTC`)
- **Turn Duration**: 2026-10-21 20:37:58 AEDT (`2026-10-21 09:37:58 UTC`)

#### User Prompt

```text
Plesae re-check DRC clearance violations
```

#### Antigravity Actions & Summary

All **3 copper-to-pad clearance violations** on `B.Cu` (`C2` Pad 1 and `U2` Pad 12) are now **resolved** (`0` pad/track clearance errors and `0` unconnected items in `kicad-cli pcb drc`). The only remaining DRC items are the **3 `copper_edge_clearance` violations** on the single vertical `-12V` spine (and its top/bottom corner arcs) on `F.Cu`:
* **Track:** `[-12V]` on `F.Cu` at `X = 20.6 mm` (`Y = 85.314 mm` to `114.126 mm`), width `0.5 mm` → **`0.3500 mm`** from the left `Edge.Cuts` line (`X = 20.0 mm`) vs. the `0.5000 mm` board setup rule.
* **Corner Arcs:** `[-12V]` on `F.Cu` at `(21.6, ...

**Key Operations Executed:**

- `run_command`: `/Applications/KiCad/KiCad.app/Contents/MacOS/kicad-cli pcb drc --output /tmp/drc_report...`
- `run_command`: `ls -la BufferedMult.kicad_pcb production/`
- `edit_file`: [`DESIGN_REVIEW.md`](file:///Users/brett/tmp/skidl-test/DESIGN_REVIEW.md)

---

### Turn 5: Please re-check DRC

- **Timestamp**: 2026-10-21 20:42:19 AEDT (`2026-10-21 09:42:19 UTC`)
- **Turn Duration**: 2026-10-21 20:43:31 AEDT (`2026-10-21 09:43:31 UTC`)

#### User Prompt

```text
Please re-check DRC
```

#### Antigravity Actions & Summary

Moving the `F.Cu` `-12V` spine to `X = 20.8 mm` resolved all copper-to-edge violations! * Running `kicad-cli pcb drc --refill-zones` on [BufferedMult.kicad_pcb](file:///Users/brett/tmp/skidl-test/BufferedMult.kicad_pcb) now reports **0 DRC errors** and **0 unconnected items**.
* Without `--refill-zones`, DRC flags the cached `F.Cu` `GND` zone fill polygon (`0.30 mm` from the moved `-12V` track vs. `0.50 mm` zone clearance) simply because the zone hasn't been refilled and saved since moving that track.

**Key Operations Executed:**

- `run_command`: `/Applications/KiCad/KiCad.app/Contents/MacOS/kicad-cli pcb drc --output /tmp/drc_report...`
- `run_command`: `/Applications/KiCad/KiCad.app/Contents/MacOS/kicad-cli pcb drc --refill-zones --output ...`
- `edit_file`: [`DESIGN_REVIEW.md`](file:///Users/brett/tmp/skidl-test/DESIGN_REVIEW.md)

---

## Key Files Created / Modified

- [`DESIGN_REVIEW.md`](file:///Users/brett/tmp/skidl-test/DESIGN_REVIEW.md) - `/Users/brett/tmp/skidl-test/DESIGN_REVIEW.md`
