domesticmouse/BufferedMult-SKiDL/prompts/10-please-re-review-the-circuit-starting-with.md

# Conversation 10: Please re-review the circuit, starting with @[/Users/brett/tmp...

- **Session ID**: `d98b5e5b-7830-4593-824d-9331d7db3262` [↗](conversation://d98b5e5b-7830-4593-824d-9331d7db3262)
- **Start Time**: 2026-10-21 20:45:41 AEDT (`2026-10-21 09:45:41 UTC`)
- **End Time**: 2026-10-21 20:48:02 AEDT (`2026-10-21 09:48:02 UTC`)
- **Duration**: 0:02:21
- **Model**: Gemini 4 Argon (Medium)
- **Workspace**: [`/Users/brett/tmp/skidl-test`](file:///Users/brett/tmp/skidl-test)
- **Project**: `skidl-test`

---

## Conversation Turns

### Turn 1: Please re-review the circuit, starting with @[/Users/bret...

- **Timestamp**: 2026-10-21 20:45:41 AEDT (`2026-10-21 09:45:41 UTC`)
- **Turn Duration**: 2026-10-21 20:48:02 AEDT (`2026-10-21 09:48:02 UTC`)

#### User Prompt

```text
Please re-review the circuit, starting with @[/Users/brett/tmp/skidl-test/DESIGN_REVIEW.md]
```

#### Antigravity Actions & Summary

I have re-reviewed the circuit, PCB, and updated production outputs (`0794e90`), and updated [DESIGN_REVIEW.md](file:///Users/brett/tmp/skidl-test/DESIGN_REVIEW.md). * **Verdict:** **PASS — READY FOR FABRICATION**
* **DRC & Connectivity (`kicad-cli pcb drc` + `analyze_pcb.py`):**
  * **0 DRC errors** and **0 unconnected items** both on the stored zone fills and with `--refill-zones` (the `F.Cu` and `B.Cu` `GND` zones are now refilled and saved in [BufferedMult.kicad_pcb](file:///Users/brett/tmp/skidl-test/BufferedMult.kicad_pcb) at `64.4%` and `59.3%` fill).
  * **21 / 21 nets completely ro...

**Key Operations Executed:**

- `read_file`: [`DESIGN_REVIEW.md`](file:///Users/brett/tmp/skidl-test/DESIGN_REVIEW.md)
- `read_file`: [`SKILL.md`](file:///Users/brett/tmp/skidl-test/.agents/skills/skidl/SKILL.md)
- `read_file`: [`SKILL.md`](file:///Users/brett/tmp/skidl-test/.agents/skills/kicad/SKILL.md)
- `read_file`: [`report-generation.md`](file:///Users/brett/tmp/skidl-test/.agents/skills/kicad/references/report-generation.md)
- `run_command`: `git status -s && git log -n 5 --oneline && ls -la && ls -la production/`
- `read_file`: [`buffered_multiple.py`](file:///Users/brett/tmp/skidl-test/buffered_multiple.py)
- `read_file`: [`bom.csv`](file:///Users/brett/tmp/skidl-test/production/bom.csv)
- `read_file`: [`positions.csv`](file:///Users/brett/tmp/skidl-test/production/positions.csv)
- `run_command`: `git show --stat 0794e90 && /Applications/KiCad/KiCad.app/Contents/MacOS/kicad-cli pcb d...`
- `run_command`: `rm -rf /tmp/gerbers_0794e90 && mkdir -p /tmp/gerbers_0794e90 && unzip -q production/Buf...`
- `run_command`: `.venv/bin/python -c "import json`
- `edit_file`: [`DESIGN_REVIEW.md`](file:///Users/brett/tmp/skidl-test/DESIGN_REVIEW.md)

---

## Key Files Created / Modified

- [`DESIGN_REVIEW.md`](file:///Users/brett/tmp/skidl-test/DESIGN_REVIEW.md) - `/Users/brett/tmp/skidl-test/DESIGN_REVIEW.md`
