domesticmouse/BufferedMult-SKiDL/prompts/11-can-you-please-plan-out-how.md

# Conversation 11: Can you please plan out how to build a eurorack front panel in...

- **Session ID**: `8dd2dc81-2770-4b0c-b64c-c19b7749be07` [↗](conversation://8dd2dc81-2770-4b0c-b64c-c19b7749be07)
- **Start Time**: 2026-10-21 21:06:06 AEDT (`2026-10-21 10:06:06 UTC`)
- **End Time**: 2026-10-21 21:41:42 AEDT (`2026-10-21 10:41:42 UTC`)
- **Duration**: 0:35:36
- **Model**: Gemini 4 Argon (Medium)
- **Workspace**: [`/Users/brett/tmp/skidl-test`](file:///Users/brett/tmp/skidl-test)
- **Project**: `skidl-test`

---

## Conversation Turns

### Turn 1: Can you please plan out how to build a eurorack front pan...

- **Timestamp**: 2026-10-21 21:06:06 AEDT (`2026-10-21 10:06:06 UTC`)
- **Turn Duration**: 2026-10-21 21:07:05 AEDT (`2026-10-21 10:07:05 UTC`)

#### User Prompt

```text
Can you please plan out how to build a eurorack front panel in kicad for this board
```

#### Antigravity Actions & Summary

Here is a complete plan to design and fabricate a **4HP (3U) Eurorack Front Panel** in **KiCad 10** that mates directly with your existing [`BufferedMult.kicad_pcb`](file:///Users/brett/tmp/skidl-test/BufferedMult.kicad_pcb) board. ---

**Key Operations Executed:**

- `run_command`: `ls -la /Users/brett/tmp/skidl-test`
- `read_file`: [`SKILL.md`](file:///Users/brett/tmp/skidl-test/.agents/skills/kicad/SKILL.md)
- `read_file`: [`SKILL.md`](file:///Users/brett/tmp/skidl-test/.agents/skills/skidl/SKILL.md)
- `read_file`: [`README.md`](file:///Users/brett/tmp/skidl-test/README.md)
- `read_file`: [`PCB_LAYOUT_GUIDE.md`](file:///Users/brett/tmp/skidl-test/PCB_LAYOUT_GUIDE.md)
- `read_file`: [`buffered_multiple.py`](file:///Users/brett/tmp/skidl-test/buffered_multiple.py)
- `read_file`: [`DESIGN_REVIEW.md`](file:///Users/brett/tmp/skidl-test/DESIGN_REVIEW.md)
- `run_command`: `python3 /Users/brett/tmp/skidl-test/.agents/skills/kicad/scripts/analyze_pcb.py /Users/...`
- `run_command`: `python3 -c "`

---

### Turn 2: Please write this plan to disk

- **Timestamp**: 2026-10-21 21:10:03 AEDT (`2026-10-21 10:10:03 UTC`)
- **Turn Duration**: 2026-10-21 21:10:48 AEDT (`2026-10-21 10:10:48 UTC`)

#### User Prompt

```text
Please write this plan to disk
```

#### Antigravity Actions & Summary

I have saved the plan to [`FRONT_PANEL_GUIDE.md`](file:///Users/brett/tmp/skidl-test/FRONT_PANEL_GUIDE.md).

**Key Operations Executed:**

- `write_file`: [`FRONT_PANEL_GUIDE.md`](file:///Users/brett/tmp/skidl-test/FRONT_PANEL_GUIDE.md)

---

### Turn 3: How would you create the kicad pcb file?

- **Timestamp**: 2026-10-21 21:16:28 AEDT (`2026-10-21 10:16:28 UTC`)
- **Turn Duration**: 2026-10-21 21:16:49 AEDT (`2026-10-21 10:16:49 UTC`)

#### User Prompt

```text
How would you create the kicad pcb file?
```

#### Antigravity Actions & Summary

I would create `BufferedMult_Panel.kicad_pcb` programmatically with a small, reproducible Python script (`generate_panel.py`) that uses **KiCad 10's `pcbnew` Python API** (or direct S-expression generation) and **`kicad-cli`** (`10.0.1`, which is installed in `/Applications/KiCad/KiCad.app`). Here is how that pipeline works step by step:

**Key Operations Executed:**

- `run_command`: `/Applications/KiCad/KiCad.app/Contents/MacOS/kicad-cli --version && /Applications/KiCad...`

---

### Turn 4: Please go ahead

- **Timestamp**: 2026-10-21 21:18:53 AEDT (`2026-10-21 10:18:53 UTC`)
- **Turn Duration**: 2026-10-21 21:31:28 AEDT (`2026-10-21 10:31:28 UTC`)

#### User Prompt

```text
Please go ahead
```

#### Antigravity Actions & Summary

I have created the generator script, the KiCad 10 front panel PCB, and the fabrication Gerbers/drills:

**Key Operations Executed:**

- `read_file`: [`BufferedMult.kicad_pcb`](file:///Users/brett/tmp/skidl-test/BufferedMult.kicad_pcb)
- `run_command`: `python3 -c "`
- `write_file`: [`generate_panel.py`](file:///Users/brett/tmp/skidl-test/generate_panel.py)
- `run_command`: `chmod +x /Users/brett/tmp/skidl-test/generate_panel.py && python3 /Users/brett/tmp/skid...`
- `edit_file`: [`generate_panel.py`](file:///Users/brett/tmp/skidl-test/generate_panel.py)
- `run_command`: `python3 /Users/brett/tmp/skidl-test/generate_panel.py && /Applications/KiCad/KiCad.app/...`
- `run_command`: `mkdir -p /Users/brett/tmp/skidl-test/production/panel && /Applications/KiCad/KiCad.app/...`
- `read_file`: [`panel_front.png`](file:///tmp/panel_front.png)
- `read_file`: [`panel_back.png`](file:///tmp/panel_back.png)
- `run_command`: `ruff check --fix /Users/brett/tmp/skidl-test/generate_panel.py && ruff format /Users/br...`
- `run_command`: `ruff format /Users/brett/tmp/skidl-test/generate_panel.py && ruff check /Users/brett/tm...`

---

### Turn 5: Please run `ruff` over the python script

- **Timestamp**: 2026-10-21 21:26:16 AEDT (`2026-10-21 10:26:16 UTC`)
- **Turn Duration**: 2026-10-21 21:34:54 AEDT (`2026-10-21 10:34:54 UTC`)

#### User Prompt

```text
Please run `ruff` over the python script
```

#### Antigravity Actions & Summary

`ruff check` and `ruff format` have been run over [`generate_panel.py`](file:///Users/brett/tmp/skidl-test/generate_panel.py) (as well as [`buffered_multiple.py`](file:///Users/brett/tmp/skidl-test/buffered_multiple.py)) — all checks and formatting pass with zero warnings or errors.

**Key Operations Executed:**

- `run_command`: `ruff check --fix /Users/brett/tmp/skidl-test/generate_panel.py && ruff format /Users/br...`
- `run_command`: `ruff check --select E,F,W,I,UP,B,SIM,EXE /Users/brett/tmp/skidl-test/generate_panel.py`
- `edit_file`: [`generate_panel.py`](file:///Users/brett/tmp/skidl-test/generate_panel.py)
- `read_file`: [`generate_panel.py`](file:///Users/brett/tmp/skidl-test/generate_panel.py)
- `run_command`: `ruff format /Users/brett/tmp/skidl-test/generate_panel.py && ruff check --select E,F,W,...`
- `run_command`: `ruff check --select E,F,W,I,UP,B,SIM,EXE /Users/brett/tmp/skidl-test/generate_panel.py ...`
- `run_command`: `ruff check /Users/brett/tmp/skidl-test/generate_panel.py /Users/brett/tmp/skidl-test/bu...`

---

### Turn 6: /agy-customizations Please turn this script into a skill

- **Timestamp**: 2026-10-21 21:35:37 AEDT (`2026-10-21 10:35:37 UTC`)
- **Turn Duration**: 2026-10-21 21:41:42 AEDT (`2026-10-21 10:41:42 UTC`)

#### User Prompt

```text
/agy-customizations Please turn this script into a skill
```

#### Antigravity Actions & Summary

I have packaged the script and workflow into the **`eurorack-panel`** workspace skill under [`.agents/skills/eurorack-panel/`](file:///Users/brett/tmp/skidl-test/.agents/skills/eurorack-panel):

**Key Operations Executed:**

- `read_file`: [`SKILL.md`](file:///Users/brett/.gemini/antigravity/builtin/skills/agy-customizations/SKILL.md)
- `read_file`: [`skills.md`](file:///Users/brett/.gemini/antigravity/builtin/skills/agy-customizations/docs/skills.md)
- `run_command`: `ls -la /Users/brett/tmp/skidl-test/.agents/skills/`
- `run_command`: `ls -la /Users/brett/tmp/skidl-test/.agents/skills/skidl /Users/brett/tmp/skidl-test/.ag...`
- `write_file`: [`eurorack_mechanical_spec.md`](file:///Users/brett/tmp/skidl-test/.agents/skills/eurorack-panel/references/eurorack_mechanical_spec.md)
- `write_file`: [`generate_eurorack_panel.py`](file:///Users/brett/tmp/skidl-test/.agents/skills/eurorack-panel/scripts/generate_eurorack_panel.py)
- `write_file`: [`SKILL.md`](file:///Users/brett/tmp/skidl-test/.agents/skills/eurorack-panel/SKILL.md)
- `run_command`: `chmod +x /Users/brett/tmp/skidl-test/.agents/skills/eurorack-panel/scripts/generate_eur...`
- `edit_file`: [`generate_eurorack_panel.py`](file:///Users/brett/tmp/skidl-test/.agents/skills/eurorack-panel/scripts/generate_eurorack_panel.py)
- `run_command`: `ruff format /Users/brett/tmp/skidl-test/.agents/skills/eurorack-panel/scripts/generate_...`
- `run_command`: `rm -f /Users/brett/tmp/skidl-test/generate_panel.py`
- `read_file`: [`FRONT_PANEL_GUIDE.md`](file:///Users/brett/tmp/skidl-test/FRONT_PANEL_GUIDE.md)
- `edit_file`: [`FRONT_PANEL_GUIDE.md`](file:///Users/brett/tmp/skidl-test/FRONT_PANEL_GUIDE.md)

---

## Key Files Created / Modified

- [`FRONT_PANEL_GUIDE.md`](file:///Users/brett/tmp/skidl-test/FRONT_PANEL_GUIDE.md) - `/Users/brett/tmp/skidl-test/FRONT_PANEL_GUIDE.md`
- [`generate_panel.py`](file:///Users/brett/tmp/skidl-test/generate_panel.py) - `/Users/brett/tmp/skidl-test/generate_panel.py`
- [`eurorack_mechanical_spec.md`](file:///Users/brett/tmp/skidl-test/.agents/skills/eurorack-panel/references/eurorack_mechanical_spec.md) - `/Users/brett/tmp/skidl-test/.agents/skills/eurorack-panel/references/eurorack_mechanical_spec.md`
- [`generate_eurorack_panel.py`](file:///Users/brett/tmp/skidl-test/.agents/skills/eurorack-panel/scripts/generate_eurorack_panel.py) - `/Users/brett/tmp/skidl-test/.agents/skills/eurorack-panel/scripts/generate_eurorack_panel.py`
- [`SKILL.md`](file:///Users/brett/tmp/skidl-test/.agents/skills/eurorack-panel/SKILL.md) - `/Users/brett/tmp/skidl-test/.agents/skills/eurorack-panel/SKILL.md`
