domesticmouse/BufferedMult-SKiDL/prompts/12-please-update-the-readme-file.md

# Conversation 12: Please update the README file

- **Session ID**: `c51f3164-342c-4dc3-85b9-59a051bba4fe` [↗](conversation://c51f3164-342c-4dc3-85b9-59a051bba4fe)
- **Start Time**: 2026-10-21 22:14:22 AEDT (`2026-10-21 11:14:22 UTC`)
- **End Time**: 2026-10-21 22:15:39 AEDT (`2026-10-21 11:15:39 UTC`)
- **Duration**: 0:01:17
- **Model**: Gemini 4 Argon (Medium)
- **Workspace**: [`/Users/brett/tmp/skidl-test`](file:///Users/brett/tmp/skidl-test)
- **Project**: `skidl-test`

---

## Conversation Turns

### Turn 1: Please update the README file

- **Timestamp**: 2026-10-21 22:14:22 AEDT (`2026-10-21 11:14:22 UTC`)
- **Turn Duration**: 2026-10-21 22:15:39 AEDT (`2026-10-21 11:15:39 UTC`)

#### User Prompt

```text
Please update the README file
```

#### Antigravity Actions & Summary

I have updated [README.md](file:///Users/brett/tmp/skidl-test/README.md) with the latest project details: - **Bill of Materials (BOM)**: Added component reference designators (`U1`–`U2`, `D1`–`D2`, `C1`–`C6`, `R1`–`R8`, `J1`–`J9`), LCSC part numbers (`C2878713`, `C2480`, `C49678`, `C149504`, `C17710`, `C713347`), and the SMT (`B.Cu` factory assembly) vs. THT (`F.Cu`/`B.Cu` hand-soldered) split.
- **Setup & Run**: Added the command to generate/update the 4HP Eurorack front panel PCB and Gerber archive via [`generate_eurorack_panel.py`](file:///Users/brett/tmp/skidl-test/.agents/skills/eurora...

**Key Operations Executed:**

- `read_file`: [`README.md`](file:///Users/brett/tmp/skidl-test/README.md)
- `run_command`: `ls -la /Users/brett/tmp/skidl-test`
- `run_command`: `git status && git log -n 10 --oneline && ls -la production/`
- `read_file`: [`buffered_multiple.py`](file:///Users/brett/tmp/skidl-test/buffered_multiple.py)
- `read_file`: [`FRONT_PANEL_GUIDE.md`](file:///Users/brett/tmp/skidl-test/FRONT_PANEL_GUIDE.md)
- `read_file`: [`DESIGN_REVIEW.md`](file:///Users/brett/tmp/skidl-test/DESIGN_REVIEW.md)
- `read_file`: [`PCB_LAYOUT_GUIDE.md`](file:///Users/brett/tmp/skidl-test/PCB_LAYOUT_GUIDE.md)
- `edit_file`: [`README.md`](file:///Users/brett/tmp/skidl-test/README.md)

---

## Key Files Created / Modified

- [`README.md`](file:///Users/brett/tmp/skidl-test/README.md) - `/Users/brett/tmp/skidl-test/README.md`
