domesticmouse/BufferedMult-SKiDL/prompts/02-what-is-required-to-turn-the.md

# Conversation 02: What is required to turn the @[buffered_multiple_bom.xml] into...

- **Session ID**: `af8a35a1-3b6d-492d-a452-7a1e5ba92e80` [↗](conversation://af8a35a1-3b6d-492d-a452-7a1e5ba92e80)
- **Start Time**: 2026-10-21 11:16:26 AEDT (`2026-10-21 00:16:26 UTC`)
- **End Time**: 2026-10-21 11:36:15 AEDT (`2026-10-21 00:36:15 UTC`)
- **Duration**: 0:19:49
- **Model**: Gemini 4 Argon (Medium)
- **Workspace**: [`/Users/brett/tmp/skidl-test`](file:///Users/brett/tmp/skidl-test)
- **Project**: `skidl-test`

---

## Conversation Turns

### Turn 1: What is required to turn the @[buffered_multiple_bom.xml]...

- **Timestamp**: 2026-10-21 11:16:26 AEDT (`2026-10-21 00:16:26 UTC`)
- **Turn Duration**: 2026-10-21 11:16:37 AEDT (`2026-10-21 00:16:37 UTC`)

#### User Prompt

```text
What is required to turn the @[buffered_multiple_bom.xml] into a JLCPCB compatible bom list?
```

#### Antigravity Actions & Summary

Turning [buffered_multiple_bom.xml](file:///Users/brett/tmp/skidl-test/buffered_multiple_bom.xml) (a KiCad-style XML netlist/BOM export from [buffered_multiple.py](file:///Users/brett/tmp/skidl-test/buffered_multiple.py)) into a **JLCPCB-compatible PCBA BOM** requires transforming the file format, grouping identical parts, and adding **LCSC Part Numbers**. Here is what is required:

**Key Operations Executed:**

- `read_file`: [`buffered_multiple_bom.xml`](file:///Users/brett/tmp/skidl-test/buffered_multiple_bom.xml)
- `read_file`: [`SKILL.md`](file:///Users/brett/tmp/skidl-test/.agents/skills/skidl/SKILL.md)
- `read_file`: [`buffered_multiple.py`](file:///Users/brett/tmp/skidl-test/buffered_multiple.py)

---

### Turn 2: Is there a way to download the JLCPCB parts catalog to as...

- **Timestamp**: 2026-10-21 11:18:44 AEDT (`2026-10-21 00:18:44 UTC`)
- **Turn Duration**: 2026-10-21 11:19:09 AEDT (`2026-10-21 00:19:09 UTC`)

#### User Prompt

```text
Is there a way to download the JLCPCB parts catalog to ascertain availability and cost?
```

#### Antigravity Actions & Summary

Yes. Depending on whether you want a **full offline database** or **real-time stock & pricing for your specific BOM**, there are three main ways to get JLCPCB's parts catalog data: ---

**Key Operations Executed:**

- `search_web`: *"jlcpcb parts catalog download sqlite csv jlcparts api"*
- `search_web`: *""selectSmtComponentList" OR "jlcsearch" jlcpcb python stock price"*

---

### Turn 3: yes please

- **Timestamp**: 2026-10-21 11:22:02 AEDT (`2026-10-21 00:22:02 UTC`)
- **Turn Duration**: 2026-10-21 11:31:41 AEDT (`2026-10-21 00:31:41 UTC`)

#### User Prompt

```text
yes please
```

#### Antigravity Actions & Summary

I have queried the live JLCPCB catalog, updated [buffered_multiple.py](file:///Users/brett/tmp/skidl-test/buffered_multiple.py) (and regenerated [buffered_multiple_bom.xml](file:///Users/brett/tmp/skidl-test/buffered_multiple_bom.xml) and [buffered_multiple.net](file:///Users/brett/tmp/skidl-test/buffered_multiple.net) with embedded `LCSC`, `MPN`, and `JLCPCB_Class` fields), and generated [buffered_multiple_jlcpcb_bom.csv](file:///Users/brett/tmp/skidl-test/buffered_multiple_jlcpcb_bom.csv). ---

**Key Operations Executed:**

- `write_file`: [`query_jlcpcb.py`](file:///Users/brett/.gemini/antigravity/brain/af8a35a1-3b6d-492d-a452-7a1e5ba92e80/scratch/query_jlcpcb.py)
- `run_command`: `python3 /Users/brett/.gemini/antigravity/brain/af8a35a1-3b6d-492d-a452-7a1e5ba92e80/scr...`
- `read_file`: [`jlcpcb_query_results.json`](file:///tmp/jlcpcb_query_results.json)
- `read_file`: [`jlcpcb_extra_results.json`](file:///tmp/jlcpcb_extra_results.json)
- `run_command`: `ls -la /Users/brett/tmp/skidl-test`
- `run_command`: `/Users/brett/tmp/skidl-test/.venv/bin/python -c "import inspect, skidl.tools.kicad9.gen...`
- `manage_task`
- `read_file`: [`gen_xml.py`](file:///Users/brett/tmp/skidl-test/.venv/lib/python3.14/site-packages/skidl/tools/kicad9/gen_xml.py)
- `read_file`: [`part.py`](file:///Users/brett/tmp/skidl-test/.venv/lib/python3.14/site-packages/skidl/part.py)
- `read_file`: [`gen_netlist.py`](file:///Users/brett/tmp/skidl-test/.venv/lib/python3.14/site-packages/skidl/tools/kicad9/gen_netlist.py)
- `read_file`: [`skidlbaseobj.py`](file:///Users/brett/tmp/skidl-test/.venv/lib/python3.14/site-packages/skidl/skidlbaseobj.py)
- `read_file`: [`buffered_multiple.py`](file:///Users/brett/tmp/skidl-test/buffered_multiple.py)
- `edit_file`: [`buffered_multiple.py`](file:///Users/brett/tmp/skidl-test/buffered_multiple.py)
- `run_command`: `/Users/brett/tmp/skidl-test/.venv/bin/python /Users/brett/tmp/skidl-test/buffered_multi...`
- `read_file`: [`skidl.py`](file:///Users/brett/tmp/skidl-test/.venv/lib/python3.14/site-packages/skidl/skidl.py)
- `read_file`: [`buffered_multiple_jlcpcb_bom.csv`](file:///Users/brett/tmp/skidl-test/buffered_multiple_jlcpcb_bom.csv)
- `read_file`: [`buffered_multiple_bom.xml`](file:///Users/brett/tmp/skidl-test/buffered_multiple_bom.xml)
- `run_command`: `ruff check --fix . && ruff format .`

---

### Turn 4: /agy-customizations Please create / update skills with wh...

- **Timestamp**: 2026-10-21 11:33:20 AEDT (`2026-10-21 00:33:20 UTC`)
- **Turn Duration**: 2026-10-21 11:36:15 AEDT (`2026-10-21 00:36:15 UTC`)

#### User Prompt

```text
/agy-customizations Please create / update skills with what was learned in this conversation
```

#### Antigravity Actions & Summary

I have updated the workspace `skidl` skill following the Antigravity Customization System guidelines (progressive disclosure via `references/` and executable helper scripts via `scripts/`):

**Key Operations Executed:**

- `read_file`: [`SKILL.md`](file:///Users/brett/.gemini/antigravity/builtin/skills/agy-customizations/SKILL.md)
- `read_file`: [`advanced_patterns.md`](file:///Users/brett/tmp/skidl-test/.agents/skills/skidl/references/advanced_patterns.md)
- `read_file`: [`skills.md`](file:///Users/brett/.gemini/antigravity/builtin/skills/agy-customizations/docs/skills.md)
- `write_file`: [`jlcpcb_search.py`](file:///Users/brett/tmp/skidl-test/.agents/skills/skidl/scripts/jlcpcb_search.py)
- `write_file`: [`jlcpcb_bom.md`](file:///Users/brett/tmp/skidl-test/.agents/skills/skidl/references/jlcpcb_bom.md)
- `edit_file`: [`SKILL.md`](file:///Users/brett/tmp/skidl-test/.agents/skills/skidl/SKILL.md)
- `read_file`: [`SKILL.md`](file:///Users/brett/tmp/skidl-test/.agents/skills/skidl/SKILL.md)
- `run_command`: `chmod +x /Users/brett/tmp/skidl-test/.agents/skills/skidl/scripts/jlcpcb_search.py && r...`
- `edit_file`: [`jlcpcb_search.py`](file:///Users/brett/tmp/skidl-test/.agents/skills/skidl/scripts/jlcpcb_search.py)
- `run_command`: `ruff check --fix . && ruff format .`

---

## Key Files Created / Modified

- [`query_jlcpcb.py`](file:///Users/brett/.gemini/antigravity/brain/af8a35a1-3b6d-492d-a452-7a1e5ba92e80/scratch/query_jlcpcb.py) - `/Users/brett/.gemini/antigravity/brain/af8a35a1-3b6d-492d-a452-7a1e5ba92e80/scratch/query_jlcpcb.py`
- [`buffered_multiple.py`](file:///Users/brett/tmp/skidl-test/buffered_multiple.py) - `/Users/brett/tmp/skidl-test/buffered_multiple.py`
- [`jlcpcb_search.py`](file:///Users/brett/tmp/skidl-test/.agents/skills/skidl/scripts/jlcpcb_search.py) - `/Users/brett/tmp/skidl-test/.agents/skills/skidl/scripts/jlcpcb_search.py`
- [`jlcpcb_bom.md`](file:///Users/brett/tmp/skidl-test/.agents/skills/skidl/references/jlcpcb_bom.md) - `/Users/brett/tmp/skidl-test/.agents/skills/skidl/references/jlcpcb_bom.md`
- [`SKILL.md`](file:///Users/brett/tmp/skidl-test/.agents/skills/skidl/SKILL.md) - `/Users/brett/tmp/skidl-test/.agents/skills/skidl/SKILL.md`
