domesticmouse/BufferedMult-SKiDL/.agents/skills/agy-brain-explorer/SKILL.md

---
name: agy-brain-explorer
description: >-
  Discover, list, inspect, compare, audit, export, archive, and safely delete Google
  Antigravity session trajectories, transcripts, disk paths, tool invocations, and execution
  steps across all brain storage directories under ~/.gemini. Use whenever asked to list recent/past
  sessions, export or archive prompt histories to Markdown, review session histories, compare
  sessions, inspect disk locations, debug trajectory steps, or delete sessions and projects.
---

# Antigravity Brain Explorer Skill

This skill provides procedures and commands to discover, inspect, and audit Antigravity session trajectories and conversation logs using the helper script [`agy-brain-explorer.py`](scripts/agy-brain-explorer.py).

## Execution Environment & Prerequisites

### 1. Always Run via `uv`
Run Python scripts using [`uv`](https://docs.astral.sh/uv/) so PEP 723 inline script dependencies (`typer>=0.12.0`) are automatically resolved and cached without manual virtual environment management.

From the workspace root:
```bash
uv run .agents/skills/agy-brain-explorer/scripts/agy-brain-explorer.py [OPTIONS] [COMMAND]
```

Or from the skill folder:
```bash
uv run scripts/agy-brain-explorer.py [OPTIONS] [COMMAND]
```

### 2. Mandatory Bypass Sandbox (`BypassSandbox: true`)
> [!IMPORTANT]
> **Always set `BypassSandbox: true` when executing `run_command`.**
> 1. Running `uv run` inside Antigravity's standard sandbox fails with `Operation not permitted (os error 1)` when attempting to spawn the Python process.
> 2. Discovering and inspecting session trajectories requires reading directory structures and JSONL transcripts located in user storage at `~/.gemini/**/brain/`, which reside outside the workspace sandbox boundary.

### 3. Native Markdown Rendering
> [!TIP]
> **All results render directly as GitHub Flavored Markdown.**
> Session IDs are formatted with copyable code plus Antigravity UI navigation links (`` `<short_id>` [↗](conversation://<full_session_uuid>) ``) so the user can easily copy the session ID to ask follow-up questions or click directly into past conversations from chat.

---

## Workflows & Command Reference

### 1. Discover and List Recent Sessions

Scan all brain directories under `~/.gemini` and display conversation traces ordered chronologically (newest first):

```bash
# List most recent 10 sessions formatted as Markdown with clickable conversation links (default)
uv run .agents/skills/agy-brain-explorer/scripts/agy-brain-explorer.py --limit 10

# Group discovered sessions by project
uv run .agents/skills/agy-brain-explorer/scripts/agy-brain-explorer.py --by-project

# Filter sessions by project name or workspace path
uv run .agents/skills/agy-brain-explorer/scripts/agy-brain-explorer.py --project "spring-petclinic"

# Filter by a specific brain root (e.g., 'antigravity-cli' or 'antigravity')
uv run .agents/skills/agy-brain-explorer/scripts/agy-brain-explorer.py --brain antigravity --limit 10

# Filter sessions by initial user prompt query
uv run .agents/skills/agy-brain-explorer/scripts/agy-brain-explorer.py -q "Please build a unified static HTML"
```

### 2. Discover Projects Across Sessions (`projects`)

View a project overview table listing all discovered projects, workspace paths, session counts, and latest active times:

```bash
# List all discovered projects across ~/.gemini brain folders
uv run .agents/skills/agy-brain-explorer/scripts/agy-brain-explorer.py projects

# Inspect all sessions within a specific project
uv run .agents/skills/agy-brain-explorer/scripts/agy-brain-explorer.py projects "spring-petclinic"
```

### 3. Search Sessions by Prompt or Deep Transcript (`search`)

Find sessions matching a prompt keyword or search across conversation turns and tool calls:

```bash
# Search sessions by initial prompt across all brain directories
uv run .agents/skills/agy-brain-explorer/scripts/agy-brain-explorer.py search "Please build a unified static HTML"

# Filter search by brain root
uv run .agents/skills/agy-brain-explorer/scripts/agy-brain-explorer.py search "build static docs" --brain antigravity-cli

# Deep search across all conversation steps (user requests, model responses, tool args, commands)
uv run .agents/skills/agy-brain-explorer/scripts/agy-brain-explorer.py search "build-docs-site.js" --all-steps

# Search within a single specific session
uv run .agents/skills/agy-brain-explorer/scripts/agy-brain-explorer.py <SESSION> search "node --test"
```

### 4. Inspect Session Overview (`summary`)

Pass a session UUID, partial prefix (e.g. `c1e9ba23`), or directory path to view metadata, timing, duration, model, workspace, and tool usage frequencies:

```bash
# Markdown formatted overview (default)
uv run .agents/skills/agy-brain-explorer/scripts/agy-brain-explorer.py <SESSION_ID_OR_PREFIX>
```

### 5. Browse Conversation Timeline (`steps`)

Display conversation turns with step numbers, timestamps, sources (`USER_EXPLICIT`, `MODEL`), types, and preview/actions:

```bash
# Markdown table of conversation steps (default)
uv run .agents/skills/agy-brain-explorer/scripts/agy-brain-explorer.py <SESSION> steps --limit 20

# Filter to steps that called tools
uv run .agents/skills/agy-brain-explorer/scripts/agy-brain-explorer.py <SESSION> steps --tools-only

# Filter to user prompt steps only
uv run .agents/skills/agy-brain-explorer/scripts/agy-brain-explorer.py <SESSION> steps --user-only
```

### 6. Drill Down into a Specific Step (`step`)

Inspect the user prompt, model thinking, exact tool call parameters, triggering action, and step output logs:

```bash
# View step 5 details formatted in Markdown
uv run .agents/skills/agy-brain-explorer/scripts/agy-brain-explorer.py <SESSION> step 5

# Limit step output log preview to 100 lines
uv run .agents/skills/agy-brain-explorer/scripts/agy-brain-explorer.py <SESSION> step 5 --lines 100
```

### 7. Audit Tool & Command Executions

Quickly review all tool invocations or shell commands run during a session:

```bash
# List all tool invocations with targets and parameters in Markdown
uv run .agents/skills/agy-brain-explorer/scripts/agy-brain-explorer.py <SESSION> tools

# Audit all shell commands run via run_command with working directories in Markdown
uv run .agents/skills/agy-brain-explorer/scripts/agy-brain-explorer.py <SESSION> commands
```

### 8. Inspect Raw JSON Records (`raw`)

Retrieve untruncated JSON step data from `transcript_full.jsonl`:

```bash
uv run .agents/skills/agy-brain-explorer/scripts/agy-brain-explorer.py <SESSION> raw 1 --full
```

### 9. Compare Two Sessions Side-by-Side (`compare`)

Compare two sessions side-by-side to review timing, duration, step counts, user turns, tool invocations, files written, and outcomes:

```bash
# Compare two sessions by IDs or prefixes
uv run .agents/skills/agy-brain-explorer/scripts/agy-brain-explorer.py compare <SESSION_1> <SESSION_2>

# Or via session inspection syntax
uv run .agents/skills/agy-brain-explorer/scripts/agy-brain-explorer.py <SESSION_1> compare <SESSION_2>
```

### 10. Inspect On-Disk Paths and Transcripts (`paths`)

Display exact disk locations and clickable file links (`file://`) for session directories, transcripts (`transcript.jsonl`, `transcript_full.jsonl`), logs, step outputs, and scratch files:

```bash
# Show disk paths for a single session
uv run .agents/skills/agy-brain-explorer/scripts/agy-brain-explorer.py <SESSION> paths

# Show disk paths for multiple sessions simultaneously
uv run .agents/skills/agy-brain-explorer/scripts/agy-brain-explorer.py paths <SESSION_1> <SESSION_2>
```

### 11. Delete Sessions and Projects (`delete` / `rm`)

Safely delete sessions by individual ID/hash, path, or project name. By default, sessions are moved to the macOS Trash (`~/.Trash`) to enable recovery if needed:

```bash
# Delete sessions by short hash or full session ID (moved to Trash by default)
uv run .agents/skills/agy-brain-explorer/scripts/agy-brain-explorer.py delete <SESSION_ID_OR_HASH>... --force

# Delete all sessions associated with a specific project
uv run .agents/skills/agy-brain-explorer/scripts/agy-brain-explorer.py delete --project "spring-petclinic" --force

# Or delete by project name directly as a positional argument
uv run .agents/skills/agy-brain-explorer/scripts/agy-brain-explorer.py delete "Buffered-Mult-Demo" --force

# Delete sessions not associated with any project
uv run .agents/skills/agy-brain-explorer/scripts/agy-brain-explorer.py delete --project "(no workspace)" --force

# Preview matching sessions and targeted actions without deleting (dry run)
uv run .agents/skills/agy-brain-explorer/scripts/agy-brain-explorer.py delete --project "gpui-testing" --dry-run

# Permanently delete from disk (rm -rf) instead of moving to Trash
uv run .agents/skills/agy-brain-explorer/scripts/agy-brain-explorer.py delete <SESSION> --permanent --force

# Delete a session using single-session syntax
uv run .agents/skills/agy-brain-explorer/scripts/agy-brain-explorer.py <SESSION> delete --force
```

### 12. Export & Archive Conversation Markdown (`export` / `archive`)

Export conversations to structured Markdown prompt files capturing user prompts (verbatim), Antigravity actions (reasoning, summaries, commands run, files modified), and precise timestamps (both local time and UTC), plus an index `README.md`:

```bash
# Export all conversations in a project to ./prompts with an index README.md
uv run .agents/skills/agy-brain-explorer/scripts/agy-brain-explorer.py export --project "kotlin-experiment" --output ./prompts

# Export to a custom archive directory
uv run .agents/skills/agy-brain-explorer/scripts/agy-brain-explorer.py export --project "spring-petclinic" --output ./docs/conversations

# Export a single conversation by session ID or prefix
uv run .agents/skills/agy-brain-explorer/scripts/agy-brain-explorer.py <SESSION> export --output ./prompts/my-session.md

# Export without generating a README.md index
uv run .agents/skills/agy-brain-explorer/scripts/agy-brain-explorer.py export --project "gpui" --no-index
```
