domesticmouse/BufferedMult-SKiDL/BufferedMult.png

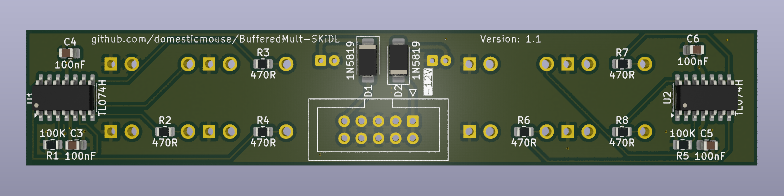
BufferedMult.png
