domesticmouse/BufferedMult-SKiDL/prompts/08-please-check-jlcpcb-parts-for-tl074h.md

# Conversation 08: Please check JLCPCB parts for TL074H SOIC

- **Session ID**: `04d450e8-f31b-45f6-a022-22b20fb043ac` [↗](conversation://04d450e8-f31b-45f6-a022-22b20fb043ac)
- **Start Time**: 2026-10-21 20:03:27 AEDT (`2026-10-21 09:03:27 UTC`)
- **End Time**: 2026-10-21 20:14:04 AEDT (`2026-10-21 09:14:04 UTC`)
- **Duration**: 0:10:37
- **Model**: Gemini 4 Argon (Medium)
- **Workspace**: [`/Users/brett/tmp/skidl-test`](file:///Users/brett/tmp/skidl-test)
- **Project**: `skidl-test`

---

## Conversation Turns

### Turn 1: Please check JLCPCB parts for TL074H SOIC

- **Timestamp**: 2026-10-21 20:03:27 AEDT (`2026-10-21 09:03:27 UTC`)
- **Turn Duration**: 2026-10-21 20:08:51 AEDT (`2026-10-21 09:08:51 UTC`)

#### User Prompt

```text
Please check JLCPCB parts for TL074H SOIC
```

#### Antigravity Actions & Summary

Here is the JLCPCB / LCSC part information for the **TL074H** in a **SOIC-14** package: ---

**Key Operations Executed:**

- `read_file`: [`SKILL.md`](file:///Users/brett/tmp/skidl-test/.agents/skills/lcsc/SKILL.md)
- `read_file`: [`SKILL.md`](file:///Users/brett/tmp/skidl-test/.agents/skills/bom/SKILL.md)
- `read_file`: [`SKILL.md`](file:///Users/brett/tmp/skidl-test/.agents/skills/jlcpcb/SKILL.md)
- `run_command`: `python3 /Users/brett/tmp/skidl-test/.agents/skills/lcsc/scripts/search_lcsc.py "TL074H"...`
- `read_file`: [`SKILL.md`](file:///Users/brett/tmp/skidl-test/.agents/skills/skidl/SKILL.md)
- `read_file`: [`jlcpcb_search.py`](file:///Users/brett/tmp/skidl-test/.agents/skills/skidl/scripts/jlcpcb_search.py)
- `run_command`: `python3 /Users/brett/tmp/skidl-test/.agents/skills/skidl/scripts/jlcpcb_search.py --lim...`
- `run_command`: `python3 /Users/brett/tmp/skidl-test/.agents/skills/lcsc/scripts/search_lcsc.py "C287871...`

---

### Turn 2: Please change the design to use this part

- **Timestamp**: 2026-10-21 20:09:47 AEDT (`2026-10-21 09:09:47 UTC`)
- **Turn Duration**: 2026-10-21 20:12:30 AEDT (`2026-10-21 09:12:30 UTC`)

#### User Prompt

```text
Please change the design to use this part
```

#### Antigravity Actions & Summary

The design has been updated to use **`TL074HIDR`** (`LCSC: C2878713`, `SOIC-14`):

**Key Operations Executed:**

- `run_command`: `ls -la /Users/brett/tmp/skidl-test`
- `read_file`: [`buffered_multiple.py`](file:///Users/brett/tmp/skidl-test/buffered_multiple.py)
- `read_file`: [`DESIGN_REVIEW.md`](file:///Users/brett/tmp/skidl-test/DESIGN_REVIEW.md)
- `read_file`: [`README.md`](file:///Users/brett/tmp/skidl-test/README.md)
- `read_file`: [`PCB_LAYOUT_GUIDE.md`](file:///Users/brett/tmp/skidl-test/PCB_LAYOUT_GUIDE.md)
- `read_file`: [`buffered_multiple_jlcpcb_bom.csv`](file:///Users/brett/tmp/skidl-test/buffered_multiple_jlcpcb_bom.csv)
- `run_command`: `grep -rn "C12594\|TL074" /Users/brett/tmp/skidl-test/ --exclude-dir=.git --exclude-dir=...`
- `run_command`: `grep -n "TL074" /Applications/KiCad/KiCad.app/Contents/SharedSupport/symbols/Amplifier_...`
- `read_file`: [`BufferedMult.kicad_pcb`](file:///Users/brett/tmp/skidl-test/BufferedMult.kicad_pcb)
- `read_file`: [`bom.csv`](file:///Users/brett/tmp/skidl-test/production/bom.csv)
- `edit_file`: [`buffered_multiple.py`](file:///Users/brett/tmp/skidl-test/buffered_multiple.py)
- `edit_file`: [`BufferedMult.kicad_pcb`](file:///Users/brett/tmp/skidl-test/BufferedMult.kicad_pcb)
- `edit_file`: [`bom.csv`](file:///Users/brett/tmp/skidl-test/production/bom.csv)
- `edit_file`: [`README.md`](file:///Users/brett/tmp/skidl-test/README.md)
- `edit_file`: [`PCB_LAYOUT_GUIDE.md`](file:///Users/brett/tmp/skidl-test/PCB_LAYOUT_GUIDE.md)
- `run_command`: `/Users/brett/tmp/skidl-test/.venv/bin/python /Users/brett/tmp/skidl-test/buffered_multi...`
- `run_command`: `ruff check --fix . && ruff format .`
- `run_command`: `git status`
- `run_command`: `git checkout -- .agents && ruff check --fix buffered_multiple.py buffered_multiple_skli...`
- `run_command`: `git status -s`

---

### Turn 3: What are the warnings found while generating the netlist?

- **Timestamp**: 2026-10-21 20:12:51 AEDT (`2026-10-21 09:12:51 UTC`)
- **Turn Duration**: 2026-10-21 20:14:04 AEDT (`2026-10-21 09:14:04 UTC`)

#### User Prompt

```text
What are the warnings found while generating the netlist?
```

#### Antigravity Actions & Summary

All warnings from the run are recorded in [`buffered_multiple.log`](file:///Users/brett/tmp/skidl-test/buffered_multiple.log). The **"6 warnings found while generating netlist"** count comes from two sources—5 `fp-lib-table` warnings during part instantiation plus 1 root-node tag warning during `generate_netlist()`: ---

**Key Operations Executed:**

- `read_file`: [`buffered_multiple.log`](file:///Users/brett/tmp/skidl-test/buffered_multiple.log)
- `read_file`: [`buffered_multiple.erc`](file:///Users/brett/tmp/skidl-test/buffered_multiple.erc)
- `run_command`: `grep -rn "warnings found while generating" /Users/brett/tmp/skidl-test/.venv/lib/`
- `run_command`: `find /Users/brett/tmp/skidl-test/.venv -name "circuit.py" -o -name "logger.py"`
- `read_file`: [`circuit.py`](file:///Users/brett/tmp/skidl-test/.venv/lib/python3.14/site-packages/skidl/circuit.py)
- `run_command`: `find /Users/brett/tmp/skidl-test/.venv/lib/python3.14/site-packages/skidl -name "*.py"`
- `read_file`: [`node.py`](file:///Users/brett/tmp/skidl-test/.venv/lib/python3.14/site-packages/skidl/node.py)
- `read_file`: [`gen_netlist.py`](file:///Users/brett/tmp/skidl-test/.venv/lib/python3.14/site-packages/skidl/tools/kicad10/gen_netlist.py)
- `read_file`: [`skidlbaseobj.py`](file:///Users/brett/tmp/skidl-test/.venv/lib/python3.14/site-packages/skidl/skidlbaseobj.py)
- `read_file`: [`logger.py`](file:///Users/brett/tmp/skidl-test/.venv/lib/python3.14/site-packages/skidl/logger.py)

---

## Key Files Created / Modified

- [`buffered_multiple.py`](file:///Users/brett/tmp/skidl-test/buffered_multiple.py) - `/Users/brett/tmp/skidl-test/buffered_multiple.py`
- [`BufferedMult.kicad_pcb`](file:///Users/brett/tmp/skidl-test/BufferedMult.kicad_pcb) - `/Users/brett/tmp/skidl-test/BufferedMult.kicad_pcb`
- [`bom.csv`](file:///Users/brett/tmp/skidl-test/production/bom.csv) - `/Users/brett/tmp/skidl-test/production/bom.csv`
- [`README.md`](file:///Users/brett/tmp/skidl-test/README.md) - `/Users/brett/tmp/skidl-test/README.md`
- [`PCB_LAYOUT_GUIDE.md`](file:///Users/brett/tmp/skidl-test/PCB_LAYOUT_GUIDE.md) - `/Users/brett/tmp/skidl-test/PCB_LAYOUT_GUIDE.md`
