domesticmouse/BufferedMult-SKiDL/production/bom.csv

Designator | Footprint | Quantity | Value | LCSC Part #
C1, C2 | CP_Radial_D5.0mm_P2.00mm | 2 | 10uF | ECEA1EKS100
C3, C4, C5, C6, C7, C8 | 0603 | 6 | 100nF | C14663
D1, D2 | D_SOD-323 | 2 | 1N5819WS | C191023
D3, D4, D5 | D_SOD-323 | 3 | PESD12VL1BA | C38558
J1 | IDC-Header_2x05_P2.54mm_Vertical | 1 | EURORACK_PWR_10PIN
J10 | Jack_3.5mm_QingPu_WQP-PJ398SM_Vertical_CircularHoles | 1 | IN_3 | WQP-PJ398SM
J11 | Jack_3.5mm_QingPu_WQP-PJ398SM_Vertical_CircularHoles | 1 | OUT_3A | WQP-PJ398SM
J12 | Jack_3.5mm_QingPu_WQP-PJ398SM_Vertical_CircularHoles | 1 | OUT_3B | WQP-PJ398SM
J13 | Jack_3.5mm_QingPu_WQP-PJ398SM_Vertical_CircularHoles | 1 | OUT_3C | WQP-PJ398SM
J2 | Jack_3.5mm_QingPu_WQP-PJ398SM_Vertical_CircularHoles | 1 | IN_1 | WQP-PJ398SM
J3 | Jack_3.5mm_QingPu_WQP-PJ398SM_Vertical_CircularHoles | 1 | OUT_1A | WQP-PJ398SM
J4 | Jack_3.5mm_QingPu_WQP-PJ398SM_Vertical_CircularHoles | 1 | OUT_1B | WQP-PJ398SM
J5 | Jack_3.5mm_QingPu_WQP-PJ398SM_Vertical_CircularHoles | 1 | OUT_1C | WQP-PJ398SM
J6 | Jack_3.5mm_QingPu_WQP-PJ398SM_Vertical_CircularHoles | 1 | IN_2 | WQP-PJ398SM
J7 | Jack_3.5mm_QingPu_WQP-PJ398SM_Vertical_CircularHoles | 1 | OUT_2A | WQP-PJ398SM
J8 | Jack_3.5mm_QingPu_WQP-PJ398SM_Vertical_CircularHoles | 1 | OUT_2B | WQP-PJ398SM
J9 | Jack_3.5mm_QingPu_WQP-PJ398SM_Vertical_CircularHoles | 1 | OUT_2C | WQP-PJ398SM
R1, R11, R6 | 0603 | 3 | 100K | C25803
R10, R13, R14, R15, R3, R4, R5, R8, R9 | 0603 | 9 | 470R | C23179
R12, R2, R7 | 0603 | 3 | 1K | C21190
U1, U2, U3 | SOIC-14_3.9x8.7mm_P1.27mm | 3 | TL074H | C2878713
