domesticmouse/BufferedMult-SKiDL/FRONT_PANEL_GUIDE.md

# KiCad 10 Eurorack Front Panel Plan — Buffered Multiple (4HP)

This guide plans out the design and fabrication of a **4HP (3U) Eurorack Front Panel** in **KiCad 10** (`BufferedMult_Panel.kicad_pcb`) to mate directly with [`BufferedMult.kicad_pcb`](BufferedMult.kicad_pcb) for the **Triple 1-to-3 (Normalized to 1-to-6 / 1-to-9)** Buffered Multiple.

---

## 1. Mechanical & Alignment Specifications

- **Main PCB (`BufferedMult.kicad_pcb`)**: `20.0 × 109.0 mm` (4HP), with `Edge.Cuts` spanning `(20.0, 19.0)` to `(40.0, 128.0)`.
- **Front Panel (`BufferedMult_Panel.kicad_pcb`)**: **`20.0 × 128.5 mm`** (Doepfer A-100 3U × 4HP standard), `1.6 mm` FR-4 (or `2.0 mm` aluminum).
- **Vertical PCB-to-Panel Centering**: Centering the `109.0 mm` main PCB behind the `128.5 mm` front panel gives **`9.75 mm`** of clearance at both the top and bottom edges (`(128.5 - 109.0) / 2 = 9.75 mm`), clearing standard `~7.5 mm` Eurorack rail lips with `2.25 mm` to spare.
- **Board-to-Panel Standoff Height**: The 12× `WQP-PJ398SM` (Thonkiconn) jacks establish a **`10.5 mm`** spacing between the front surface of `BufferedMult.kicad_pcb` (`F.Cu`) and the rear surface of the front panel (`B.Cu`), which clears the `7.0 mm` tall radial electrolytic bulk capacitors (`C1`, `C2` on `F.Cu`) by `3.5 mm`.
- **Thonkiconn Bushing Offset (`+6.48 mm` in Y)**:
  - In KiCad's `Connector_Audio:Jack_3.5mm_QingPu_WQP-PJ398SM_Vertical_CircularHoles` footprint (all placed at `rotation = 0` on `F.Cu`), the footprint origin `(0, 0)` is **Pad `S` (Sleeve)**.
  - The **threaded M6 bushing shaft center** (`fp_circle`) is offset by **`(0, +6.48 mm)`** relative to the footprint origin.
  - All front-panel jack holes must be placed at the **bushing center** coordinates below.

```mermaid
flowchart TD
    subgraph Panel["4HP Front Panel (20.0 × 128.5 mm)"]
        M_TOP["Top M3 Mounting Slot<br/>X = 7.5 mm, Y = 3.0 mm"]
        subgraph CH1["Channel 1 (1-to-3)"]
            R1["Row 1 (Y = 18.63 mm)<br/>Left: J2 (IN 1) @ X = 5.0 mm<br/>Right: J3 (OUT 1A) @ X = 15.0 mm"]
            R2["Row 2 (Y = 33.03 mm)<br/>Left: J4 (OUT 1B) @ X = 5.0 mm<br/>Right: J5 (OUT 1C) @ X = 15.0 mm"]
        end
        subgraph CH2["Channel 2 (Normalled 1-to-6)"]
            R3["Row 3 (Y = 47.43 mm)<br/>Left: J6 (IN 2) @ X = 5.0 mm<br/>Right: J7 (OUT 2A) @ X = 15.0 mm"]
            R4["Row 4 (Y = 61.83 mm)<br/>Left: J8 (OUT 2B) @ X = 5.0 mm<br/>Right: J9 (OUT 2C) @ X = 15.0 mm"]
        end
        subgraph CH3["Channel 3 (Normalled 1-to-9)"]
            R5["Row 5 (Y = 76.23 mm)<br/>Left: J10 (IN 3) @ X = 5.0 mm<br/>Right: J11 (OUT 3A) @ X = 15.0 mm"]
            R6["Row 6 (Y = 90.63 mm)<br/>Left: J12 (OUT 3B) @ X = 5.0 mm<br/>Right: J13 (OUT 3C) @ X = 15.0 mm"]
        end
        M_BOT["Bottom M3 Mounting Slot<br/>X = 7.5 mm, Y = 125.5 mm"]
    end
```

### Coordinate Table (3-Channel / 12-Jack Layout)

The table below provides the 6-row × 2-column coordinates (`14.40 mm` uniform vertical row pitch) in both:
1. **Main PCB Coordinate Space** — where the main PCB spans `X = 20.0..40.0 mm`, `Y = 19.0..128.0 mm`, and the centered front panel spans `X = 20.0..40.0 mm`, `Y = 9.25..137.75 mm`.
2. **Panel-Local Coordinate Space** — where the top-left corner of the front panel is `(0.0, 0.0)` and the bottom-right corner is `(20.0, 128.5)` (`X_panel = X_pcb - 20.0`, `Y_panel = Y_pcb - 9.25`).

| Feature | Ref / Function | Main PCB Footprint `(X, Y)` | Main PCB Bushing `(X, Y)` | **Panel-Local `(X, Y)`** *(Top-Left = `0, 0`)* | Hole / Cutout Size |
| :--- | :--- | :---: | :---: | :---: | :--- |
| **Panel Outline** | 4HP × 3U Doepfer Standard | `X: 20.0..40.0`<br>`Y: 9.25..137.75` | — | **`0.0, 0.0` → `20.0, 128.5 mm`** | `0.5 mm` corner fillets (optional) |
| **Top Rack Slot** | M3 Rail Screw | `(27.50, 12.25)` | — | **`(7.50, 3.00 mm)`** | `3.2 × 5.5 mm` NPTH oval slot (or `3.2 mm` hole) |
| **Bottom Rack Slot** | M3 Rail Screw | `(27.50, 134.75)` | — | **`(7.50, 125.50 mm)`** | `3.2 × 5.5 mm` NPTH oval slot (or `3.2 mm` hole) |
| **Row 1 — Left** | **`J2` (`IN 1`)** | `(25.00, 21.40)` | `(25.00, 27.88)` | **`(5.00, 18.63 mm)`** | `6.2 mm` PTH grounded hole |
| **Row 1 — Right** | **`J3` (`OUT 1A`)** | `(35.00, 21.40)` | `(35.00, 27.88)` | **`(15.00, 18.63 mm)`** | `6.2 mm` PTH grounded hole |
| **Row 2 — Left** | **`J4` (`OUT 1B`)** | `(25.00, 35.80)` | `(25.00, 42.28)` | **`(5.00, 33.03 mm)`** | `6.2 mm` PTH grounded hole |
| **Row 2 — Right** | **`J5` (`OUT 1C`)** | `(35.00, 35.80)` | `(35.00, 42.28)` | **`(15.00, 33.03 mm)`** | `6.2 mm` PTH grounded hole |
| **Row 3 — Left** | **`J6` (`IN 2`)** | `(25.00, 50.20)` | `(25.00, 56.68)` | **`(5.00, 47.43 mm)`** | `6.2 mm` PTH grounded hole |
| **Row 3 — Right** | **`J7` (`OUT 2A`)** | `(35.00, 50.20)` | `(35.00, 56.68)` | **`(15.00, 47.43 mm)`** | `6.2 mm` PTH grounded hole |
| **Row 4 — Left** | **`J8` (`OUT 2B`)** | `(25.00, 64.60)` | `(25.00, 71.08)` | **`(5.00, 61.83 mm)`** | `6.2 mm` PTH grounded hole |
| **Row 4 — Right** | **`J9` (`OUT 2C`)** | `(35.00, 64.60)` | `(35.00, 71.08)` | **`(15.00, 61.83 mm)`** | `6.2 mm` PTH grounded hole |
| **Row 5 — Left** | **`J10` (`IN 3`)** | `(25.00, 79.00)` | `(25.00, 85.48)` | **`(5.00, 76.23 mm)`** | `6.2 mm` PTH grounded hole |
| **Row 5 — Right** | **`J11` (`OUT 3A`)** | `(35.00, 79.00)` | `(35.00, 85.48)` | **`(15.00, 76.23 mm)`** | `6.2 mm` PTH grounded hole |
| **Row 6 — Left** | **`J12` (`OUT 3B`)** | `(25.00, 93.40)` | `(25.00, 99.88)` | **`(5.00, 90.63 mm)`** | `6.2 mm` PTH grounded hole |
| **Row 6 — Right** | **`J13` (`OUT 3C`)** | `(35.00, 93.40)` | `(35.00, 99.88)` | **`(15.00, 90.63 mm)`** | `6.2 mm` PTH grounded hole |

---

## 2. Step-by-Step KiCad 10 Workflow

### Step 1: Create a Standalone Panel Board (`BufferedMult_Panel.kicad_pcb`)
Creating a standalone `.kicad_pcb` file (no schematic required) allows you to order the front panel with its own solder-mask color (e.g., matte black with gold ENIG or white silkscreen) and order quantity without modifying [`BufferedMult.kicad_pcb`](BufferedMult.kicad_pcb):
1. Open KiCad 10 **PCB Editor** (`pcbnew`) and save a new board as `BufferedMult_Panel.kicad_pcb`.
2. Set the grid origin to `(0, 0)` (or temporarily use the main PCB's coordinate space so you can paste footprints between boards at identical coordinates to verify alignment).

### Step 2: Draw the 4HP × 3U Outline on `Edge.Cuts`
1. Select the **`Edge.Cuts`** layer.
2. Draw a rectangle from **`(0.0, 0.0)`** to **`(20.0, 128.5 mm)`** (width = `20.0 mm`, height = `128.5 mm`).
3. *(Optional)* Add `0.5 mm` corner fillets to soften the panel corners.

### Step 3: Place the 12 Jack Holes & 2 Rack Mounting Slots
Use non-plated through-hole (`NPTH`) footprints so holes and slots are exported cleanly in the Excellon drill file:
1. **12× Thonkiconn (`WQP-PJ398SM`) Jack Holes**:
   - Place 12 `NPTH` pads with a **`6.2 mm` circular drill** at the 12 jack coordinates in the table above (`X = 5.0 mm` and `X = 15.0 mm`; `Y = 23.73, 37.23, 55.73, 69.23, 87.73, 101.23 mm`).
   - Draw a **`9.5 mm` diameter (`4.75 mm` radius)** reference circle on **`F.Fab`** or **`User.Drawings`** around each hole center to represent the outer diameter of the M6 knurled/hex nut so text and graphics remain outside the nut footprint.
2. **2× Eurorack M3 Mounting Slots**:
   - Place two `NPTH` oval slots (`5.5 mm × 3.2 mm` slot size, `5.5 mm × 3.2 mm` pad size) centered at **`(7.50, 3.00 mm)`** and **`(7.50, 125.50 mm)`**.

### Step 4: Front Panel Graphics, Labels & Ground Shielding
A standard FR-4 PCB front panel offers three high-contrast visual layers:
1. **Silkscreen (`F.Silkscreen`)**:
   - **Module Title**: Place `BUF MULT` or `1:3 / 1:6 / 1:9` centered horizontally (`X = 10.0 mm`) near `Y = 10.5 mm`.
   - **Jack Labels**: Place labels (`IN 1`, `1A`, `1B`, `1C`, `IN 2`, `2A`, `2B`, `2C`, `IN 3`, `3A`, `3B`, `3C`) at least `5.5 mm` above or below each jack hole center so they are not obscured by the M6 nuts:
     - Row 1 labels above holes at **`Y = 17.5 mm`** (`IN 1` at `X = 5.0 mm`, `OUT 1A` at `X = 15.0 mm`)
     - Row 2 labels below holes at **`Y = 43.5 mm`** (`OUT 1B` at `X = 5.0 mm`, `OUT 1C` at `X = 15.0 mm`)
     - Row 3 labels above holes at **`Y = 49.5 mm`** (`IN 2` at `X = 5.0 mm`, `OUT 2A` at `X = 15.0 mm`)
     - Row 4 labels below holes at **`Y = 75.5 mm`** (`OUT 2B` at `X = 5.0 mm`, `OUT 2C` at `X = 15.0 mm`)
     - Row 5 labels above holes at **`Y = 81.5 mm`** (`IN 3` at `X = 5.0 mm`, `OUT 3A` at `X = 15.0 mm`)
     - Row 6 labels below holes at **`Y = 107.5 mm`** (`OUT 3B` at `X = 5.0 mm`, `OUT 3C` at `X = 15.0 mm`)
   - **Normalled Cascade Graphics (`CH1 → IN 2` and `CH2 → IN 3`)**: Use the `18.5 mm` vertical spans between Row 2 & Row 3 and between Row 4 & Row 5 to draw vertical normalling arrows indicating that Channel 1 cascades into `IN 2` and Channel 2 cascades into `IN 3` when unpatched.
2. **Input Jack Visual Callout (`IN 1`, `IN 2`, & `IN 3`)**:
   - Draw a filled silkscreen badge (or exposed ENIG gold/HASL ring on **`F.Cu` + `F.Mask`**) around **`J2` (`IN 1`)** at `(5.00, 23.73 mm)`, **`J6` (`IN 2`)** at `(5.00, 55.73 mm)`, and **`J10` (`IN 3`)** at `(5.00, 87.73 mm)` to visually distinguish inputs from outputs.
3. **Copper Shielding & Panel Grounding (`F.Cu` & `B.Cu`)**:
   - Pour solid copper zones across both **`F.Cu`** (tented under solder mask) and **`B.Cu`** (with `0.4 mm` edge pullback) to block light bleed through the FR-4 substrate and stiffen the panel.
   - *(Optional)* Add an exposed copper ring (`B.Mask` opening, `9.0 mm` outer diameter) on **`B.Cu`** around the back of the jack holes—or convert the jack holes to plated through-holes (`PTH`) tied to the copper pour—so tightening the jack nuts grounds the panel copper planes directly to the jack sleeves (`GND`).
   - Add a PCB manufacturer order-number placeholder text **`JLCJLCJLCJLC`** on **`B.Silkscreen`** so the fab house places the production barcode on the rear face of the panel rather than the front.

### Step 5: Mechanical Verification & Gerber Export
1. **Overlay Alignment Check**:
   - Temporarily copy the panel outline and 12 jack hole circles onto `User.Eco1` of [`BufferedMult.kicad_pcb`](BufferedMult.kicad_pcb) at `(20.0, 9.75)` to `(40.0, 138.25)` and verify that all 12 `6.2 mm` holes sit concentrically around the `fp_circle` bushing centers of `J2`–`J13`.
2. **Design Rules Check (`DRC`)**:
   - Run `kicad-cli pcb drc BufferedMult_Panel.kicad_pcb` and verify `0` errors.
3. **Export Fabrication Outputs (`production/panel/`)**:
   - Plot Gerber layers (`F.Cu`, `B.Cu`, `F.Silkscreen`, `B.Silkscreen`, `F.Mask`, `B.Mask`, `Edge.Cuts`) and Excellon drill files (`PTH` and `NPTH`) into `production/panel/`, then zip as `production/BufferedMult_Panel.zip`.

---

## 3. Automated Generation via the `eurorack-panel` Skill

You can inspect the main board coordinates, generate [`BufferedMult_Panel.kicad_pcb`](BufferedMult_Panel.kicad_pcb), refill copper zones, run DRC, and export Gerbers/drills in one command using [`generate_eurorack_panel.py`](.agents/skills/eurorack-panel/scripts/generate_eurorack_panel.py):

```bash
# Inspect jack coordinates and bushing offsets
python3 .agents/skills/eurorack-panel/scripts/generate_eurorack_panel.py \
    --main-pcb BufferedMult.kicad_pcb \
    --inspect

# Generate the front panel PCB, run DRC, and export Gerbers + zip archive
python3 .agents/skills/eurorack-panel/scripts/generate_eurorack_panel.py \
    --main-pcb BufferedMult.kicad_pcb \
    --output BufferedMult_Panel.kicad_pcb \
    --title "BUF MULT" \
    --subtitle "1:3 / 1:6 / 1:9" \
    --gerber-dir production/panel \
    --zip production/BufferedMult_Panel.zip \
    --drc
```
