domesticmouse/BufferedMult-SKiDL/BufferedMult.kicad_pcb

## KiCad design BufferedMult.kicad_pcb (2026-10-24)

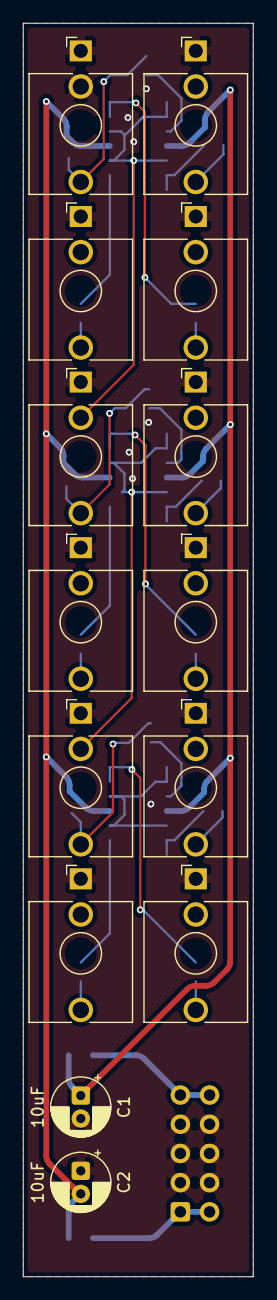
[picture p3: board BufferedMult.kicad_pcb from above]

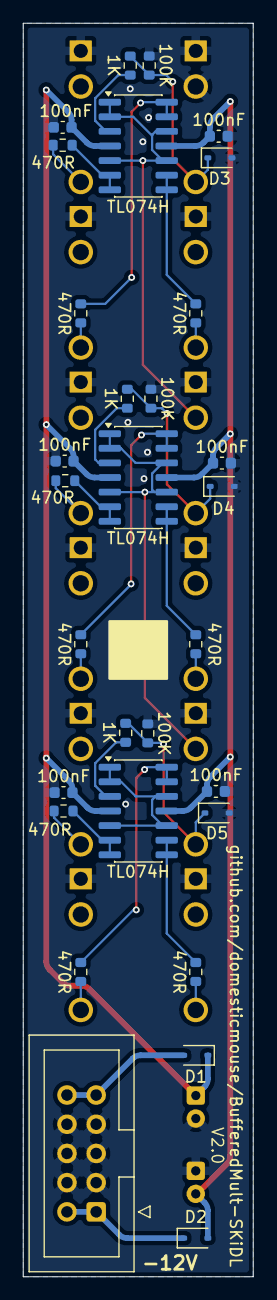
[picture p4: board BufferedMult.kicad_pcb from below]

Board: 2 copper layers, 20.0 x 109.0 mm, 44 parts (30 on the bottom side), 32 nets.

Parts:
C1, C2: 10uF; CP_Radial_D5.0mm_P2.00mm
C3, C4, C5, C6, C7, C8: 100nF; C_0603_1608Metric
D1, D2: 1N5819WS; D_SOD-323
D3, D4, D5: PESD12VL1BA; D_SOD-323
J1: EURORACK_PWR_10PIN; IDC-Header_2x05_P2.54mm_Vertical
J2: IN_1; Jack_3.5mm_QingPu_WQP-PJ398SM_Vertical_CircularHoles
J3: OUT_1A; Jack_3.5mm_QingPu_WQP-PJ398SM_Vertical_CircularHoles
J4: OUT_1B; Jack_3.5mm_QingPu_WQP-PJ398SM_Vertical_CircularHoles
J5: OUT_1C; Jack_3.5mm_QingPu_WQP-PJ398SM_Vertical_CircularHoles
J6: IN_2; Jack_3.5mm_QingPu_WQP-PJ398SM_Vertical_CircularHoles
J7: OUT_2A; Jack_3.5mm_QingPu_WQP-PJ398SM_Vertical_CircularHoles
J8: OUT_2B; Jack_3.5mm_QingPu_WQP-PJ398SM_Vertical_CircularHoles
J9: OUT_2C; Jack_3.5mm_QingPu_WQP-PJ398SM_Vertical_CircularHoles
J10: IN_3; Jack_3.5mm_QingPu_WQP-PJ398SM_Vertical_CircularHoles
J11: OUT_3A; Jack_3.5mm_QingPu_WQP-PJ398SM_Vertical_CircularHoles
J12: OUT_3B; Jack_3.5mm_QingPu_WQP-PJ398SM_Vertical_CircularHoles
J13: OUT_3C; Jack_3.5mm_QingPu_WQP-PJ398SM_Vertical_CircularHoles
R1, R6, R11: 100K; R_0603_1608Metric
R2, R7, R12: 1K; R_0603_1608Metric
R3, R4, R5, R8, R9, R10, R13, R14, R15: 470R; R_0603_1608Metric
U1, U2, U3: TL074H; SOIC-14_3.9x8.7mm_P1.27mm

Connections:
+12V: C1.1, C3.1, C5.1, C7.1, D1.1, U1.4, U2.4, U3.4
+12V_RAW: D1.2, J1.9, J1.10
-12V: C2.2, C4.2, C6.2, C8.2, D2.2, U1.11, U2.11, U3.11
-12V_RAW: D2.1, J1.1, J1.2
CH1_BUF: J6.TN, U1.1, U1.2, U1.5, U1.10, U1.12
CH1_IN: R2.2, U1.3
CH1_JACK_IN: D3.1, J2.T, R1.1, R2.1
CH1_OP_A: R3.1, U1.6, U1.7
CH1_OP_B: R4.1, U1.8, U1.9
CH1_OP_C: R5.1, U1.13, U1.14
CH1_OUT_A: J3.T, R3.2
CH1_OUT_B: J4.T, R4.2
CH1_OUT_C: J5.T, R5.2
CH2_BUF: J10.TN, U2.1, U2.2, U2.5, U2.10, U2.12
CH2_IN: R7.2, U2.3
CH2_JACK_IN: D4.1, J6.T, R6.1, R7.1
CH2_OP_A: R8.1, U2.6, U2.7
CH2_OP_B: R9.1, U2.8, U2.9
CH2_OP_C: R10.1, U2.13, U2.14
CH2_OUT_A: J7.T, R8.2
CH2_OUT_B: J8.T, R9.2
CH2_OUT_C: J9.T, R10.2
CH3_BUF: U3.1, U3.2, U3.5, U3.10, U3.12
CH3_IN: R12.2, U3.3
CH3_JACK_IN: D5.1, J10.T, R11.1, R12.1
CH3_OP_A: R13.1, U3.6, U3.7
CH3_OP_B: R14.1, U3.8, U3.9
CH3_OP_C: R15.1, U3.13, U3.14
CH3_OUT_A: J11.T, R13.2
CH3_OUT_B: J12.T, R14.2
CH3_OUT_C: J13.T, R15.2
GND: C1.2, C2.1, C3.2, C4.1, C5.2, C6.1, C7.2, C8.1, D3.2, D4.2, D5.2, J1.3, J1.4, J1.5, J1.6, J1.7, J1.8, J2.S, J2.TN, J3.S, J4.S, J5.S, J6.S, J7.S, J8.S, J9.S, J10.S, J11.S, J12.S, J13.S, R1.2, R6.2, R11.2
