domesticmouse/BufferedMult-SKiDL/(commit log)

2026-10-21 feat: add Eurorack Buffered Multiple SKiDL circuit and KiCad outputs
    - Implement a Dual 1-to-3 (normalized to 1-to-6) Eurorack Buffered Multiple in `buffered_multiple.py` using SKiDL and KiCad 10 libraries
    - Design hierarchical subcircuits for the 10-pin Eurorack power header with Schottky reverse-polarity protection (`eurorack_power`) and TL074-based 1-to-3 buffered channels (`buffered_channel_1to3`)
    - Assign SMD footprints for ICs and passives (SOIC-14, 0805, SMA, 6.3x5.4mm electrolytic) and through-hole footprints for QingPu 3.5mm jacks and IDC power header
    - Generate ERC report, KiCad netlist (`.net`), XML BOM (`.xml`), hierarchical SVG schematics (`.svg`), and SKiDL backup library
    - For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
2026-10-21 docs(skills): update skidl skill with environment setup, scoping, and linting guidance
    - Document creating virtual environments with Python 3.12-3.14 (`uv venv --clear`) to avoid `h5py` source build failures on bleeding-edge Python versions
    - Add pre-import `XDG_DATA_HOME`, `MPLCONFIGDIR`, and macOS KiCad 10 symbol/footprint directory configuration for sandboxed environments
    - Instruct using `pin += NC` instead of `NC += pin` inside functions and `@subcircuit` blocks to prevent `UnboundLocalError`
    - Note that `default_circuit.root.tag` must remain an empty string `""` for KiCad `gen_sheetpath` compatibility
    - Clarify `generate_svg()` vs. `generate_schematic()` routing limitations on dense mu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
2026-10-21 docs: add README for Eurorack Buffered Multiple SKiDL project
    Document the Dual 1-to-3 (normalized to 1-to-6) buffered multiple circuit
    architecture, signal flow diagram, Bill of Materials (BOM) with KiCad 10
    symbols and footprints, setup and execution instructions using uv and ruff,
    and steps for importing the generated netlist into KiCad PCB Editor.
2026-10-21 Add JLCPCB BOM CSV export and verified LCSC part fields to buffered multiple
    - Embed verified in-stock LCSC catalog numbers, MPNs, and JLCPCB library classes (`Basic` / `Extended` / `THT`) into component fields in `buffered_multiple.py`
    - Add `generate_jlcpcb_bom()` to export grouped SMT assembly BOM (`buffered_multiple_jlcpcb_bom.csv`) in JLCPCB's 4-column CSV format
    - Regenerate KiCad netlist (`.net`), XML BOM (`.xml`), backup symbol library (`_sklib.py`), and SVG schematics with updated part metadata
    [buffered_multiple_jlcpcb_bom.csv]
2026-10-21 feat(skills): add JLCPCB BOM integration and live part search to skidl skill
    - Update `.agents/skills/skidl/SKILL.md` to document `part.fields` assignment for custom netlist/XML fields, `builtins.NC` and `builtins.default_circuit` usage with explicit imports, and JLCPCB PCBA BOM workflows.
    - Add `.agents/skills/skidl/references/jlcpcb_bom.md` covering JLCPCB CSV BOM generation, Basic vs. Extended part selection, offline catalog databases, and verified LCSC part numbers.
    - Add `.agents/skills/skidl/scripts/jlcpcb_search.py` CLI helper to query live JLCPCB stock, library class, and pricing tiers with `jlcsearch` fallback.
2026-10-21 Switch Eurorack 2x5 IDC power header to SMD part C41376028
    - Update `FP_PWR_HEADER_10P` to `Connector_IDC:IDC-Header_2x05_P2.54mm_Vertical_SMD`
    - Set `LCSC_J_IDC_10P` to `C41376028` (`HX JN2.54-2x5P TP H8.9`) as an Extended SMT part
    - Regenerate KiCad netlist, XML BOM, JLCPCB SMT BOM CSV, SVG schematics, and documentation
    [buffered_multiple_jlcpcb_bom.csv]
2026-10-21 Add KiCad files
    [BufferedMult.kicad_pcb]
2026-10-21 Convert Eurorack power header and bulk capacitors to THT and exclude from JLCPCB BOM
    - Change `FP_PWR_HEADER_10P` to `Connector_IDC:IDC-Header_2x05_P2.54mm_Vertical`
    - Change `FP_C_ELEC` to `Capacitor_THT:CP_Radial_D5.0mm_P2.00mm` to match Panasonic `ECEA1EKS100` (`C713347`)
    - Mark both power header (`J1`) and bulk electrolytic capacitors (`C1`, `C2`) as manual THT parts excluded from `buffered_multiple_jlcpcb_bom.csv`
    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
    [buffered_multiple_jlcpcb_bom.csv]
2026-10-21 Add KiCad 10 PCB layout guide for Eurorack buffered multiple
    - Add `PCB_LAYOUT_GUIDE.md` detailing netlist import, 2HP/4HP board dimensions, front/back placement for SMT and THT components (`J1` power header, `C1`/`C2` radial bulk capacitors, and `J2`-`J9` Thonkiconn jacks), net classes, routing, DRC, and JLCPCB export.
    - Link `PCB_LAYOUT_GUIDE.md` from `README.md`.
2026-10-21 docs: update PCB layout guide for front-mounted bulk capacitors
    Move the radial electrolytic bulk bypass capacitors (C1, C2) to the front side (F.Cu) alongside the Eurorack jacks, leaving only the 10-pin power header (J1) and SMD components on the back side (B.Cu).
2026-10-21 Add KiCad 10 PCB layout guide and project files for Buffered Multiple
    - Add step-by-step KiCad 10 PCB layout guide (PCB_LAYOUT_GUIDE.md) covering Eurorack board dimensions, front-mounted jacks and radial bulk capacitors, rear SMD and power header placement, net classes, and JLCPCB export
    - Link PCB_LAYOUT_GUIDE.md from README.md
    - Add KiCad project and PCB files for BufferedMult
2026-10-21 Update PCB
    [BufferedMult.kicad_pcb]
2026-10-21 Reposition parts and flood the ground planes
    [BufferedMult.kicad_pcb]
2026-10-21 Repositioning components
    [BufferedMult.kicad_pcb]
2026-10-21 Production files
    [bom.csv, designators.csv, positions.csv]
2026-10-21 Add https://github.com/aklofas/kicad-happy
2026-10-21 Add comprehensive circuit and PCB design review (DESIGN_REVIEW.md)
    Document the electrical, PCB layout, DRC, EMC, and Gerber analysis findings
    for the Eurorack Buffered Multiple, including two critical PCB routing bugs
    (unconnected U1 pin 5 on CH1_BUF and isolated GND island on C5 pad 2) and
    actionable fixes.
2026-10-21 Switch quad op-amps U1/U2 from TL074CDR to TL074HIDR (LCSC C2878713)
    - Update `buffered_multiple.py` op-amp value (`TL074H`), MPN (`TL074HIDR`), and LCSC part number (`C2878713`).
    - Regenerate KiCad netlist, XML BOM, JLCPCB SMT BOM CSV, and hierarchical schematic SVGs.
    - Update `U1` and `U2` footprint properties in `BufferedMult.kicad_pcb` and `production/bom.csv`.
    - Update BOM tables and signal flow documentation in `README.md` and `PCB_LAYOUT_GUIDE.md`.
    [BufferedMult.kicad_pcb, bom.csv, buffered_multiple_jlcpcb_bom.csv]
2026-10-21 Update DESIGN_REVIEW.md after PCB re-route and TL074H upgrade
    - Confirm resolution of the two open-circuit PCB bugs (`U1` Pin 5 on `CH1_BUF` and `C5` Pad 2 on `GND`), duplicate `B.Cu` ground zone, `0.5 mm` power trace routing, and `TL074HIDR` op-amp upgrade.
    - Document 6 minor DRC clearance violations on the widened `0.5 mm` `-12V` trace near `C2` Pad 1, `U2` Pad 12, and the left board edge (`X = 20.6 mm`) to resolve before re-exporting Gerbers.
    - Refresh generated SKiDL netlist, BOM XML, and SVG artifacts.
2026-10-21 Re-route power lines
    [BufferedMult.kicad_pcb]
2026-10-21 Update design review after PCB re-route and TL074H upgrade
    - Record resolution of the two critical open-circuit bugs (U1 pin 5 on CH1_BUF and C5 pad 2 GND island), duplicate B.Cu GND zone, 0.5 mm power trace widening, B.Cu pad-to-track clearances, and TL074HIDR op-amp upgrade.
    - Add Previous Review Delta section tracking resolved items and remaining F.Cu -12V copper-to-edge clearance item (0.35 mm vs. 0.50 mm rule) prior to Gerber re-export.
2026-10-21 Move -12V power rail
    [BufferedMult.kicad_pcb]
2026-10-21 Update DESIGN_REVIEW.md after PCB re-route, TL074H upgrade, and DRC fixes
    - Record resolution of both critical open-circuit bugs (`U1` Pin 5 on `CH1_BUF` and `C5` Pad 2 on `GND`), duplicate `B.Cu` `GND` zone removal, `0.5 mm` power trace widening, and all `-12V` pad/edge DRC clearance violations.
    - Update op-amp review section for `TL074HIDR` (`TL074H`, LCSC `C2878713`).
    - Note pre-fabrication step to refill zones (`B`) and re-export `production/BufferedMult.zip`.
2026-10-21 Update Gerbers
    [BufferedMult.kicad_pcb, bom.csv]
2026-10-21 Update DESIGN_REVIEW.md after zone refill and Gerber export
    - Record final PASS (Ready for Fabrication) status after commit 0794e90
    - Verify 0 DRC errors (both stored and refilled) and 0 Gerber findings in production/BufferedMult.zip
2026-10-21 Add KiCad 10 4HP Eurorack front panel design guide
    Document mechanical alignment specifications, bushing-compensated hole coordinates, artwork layout, and Gerber export steps for building a 4HP (20.0 x 128.5 mm) front panel matching BufferedMult.kicad_pcb.
2026-10-21 Add 4HP Eurorack front panel KiCad PCB, generator script, and Gerbers
    - Add `generate_panel.py` to programmatically generate `BufferedMult_Panel.kicad_pcb` from `BufferedMult.kicad_pcb` jack coordinates and the +6.48 mm WQP-PJ398SM bushing offset
    - Add 4HP x 3U (20.0 x 128.5 mm) KiCad 10 front panel (`BufferedMult_Panel.kicad_pcb`, `.kicad_pro`, `.kicad_prl`) with 8 grounded 6.2 mm jack holes, 2 M3 oval mounting slots, front silkscreen graphics, and filled `F.Cu`/`B.Cu` `GND` shield planes
    - Export fabrication Gerber and Excellon drill files to `production/panel/` and `production/BufferedMult_Panel.zip`
    [BufferedMult_Panel-B_Cu.gbl, BufferedMult_Panel-B_Mask.gbs, BufferedMult_Panel-B_Paste.gbp, BufferedMult_Panel-B_Silkscreen.gbo, BufferedMult_Panel-Edge_Cuts.gm1, BufferedMult_Panel-F_Cu.gtl, BufferedMult_Panel-F_Mask.gts, BufferedMult_Panel-F_Paste.gtp]
2026-10-21 Add `eurorack-panel` skill and update 4HP front panel PCB and Gerbers
    - Package the front panel generator into `.agents/skills/eurorack-panel/` with `SKILL.md`, `scripts/generate_eurorack_panel.py`, and `references/eurorack_mechanical_spec.md`
    - Remove standalone root `generate_panel.py` and document the skill CLI workflow in `FRONT_PANEL_GUIDE.md`
    - Update `BufferedMult_Panel` KiCad project files and regenerate fabrication Gerbers and Excellon drill outputs in `production/`
    [BufferedMult_Panel-B_Cu.gbl, BufferedMult_Panel-B_Mask.gbs, BufferedMult_Panel-B_Paste.gbp, BufferedMult_Panel-B_Silkscreen.gbo, BufferedMult_Panel-Edge_Cuts.gm1, BufferedMult_Panel-F_Cu.gtl, BufferedMult_Panel-F_Mask.gts, BufferedMult_Panel-F_Paste.gtp]
2026-10-21 Update 4HP Eurorack front panel PCB and Gerber archive
    Regenerate `BufferedMult_Panel.kicad_pcb` and `production/BufferedMult_Panel.zip` using the `eurorack-panel` generator script with filled `F.Cu`/`B.Cu` `GND` shield zones, grounded `6.2 mm` jack cutouts aligned to `BufferedMult.kicad_pcb`, M3 mounting slots, and silkscreen panel graphics. Verify zero DRC and Gerber findings.
    [BufferedMult_Panel.kicad_pcb]
2026-10-21 Update README with LCSC BOM, 4HP front panel, fabrication files, and project guides
    - Expand BOM table with reference designators, LCSC part numbers, and SMT vs. THT assembly split
    - Add CLI command for generating the 4HP Eurorack front panel PCB and Gerbers
    - Document `buffered_multiple_jlcpcb_bom.csv` and ERC/log outputs
    - Detail `BufferedMult.kicad_pcb`, `BufferedMult_Panel.kicad_pcb`, and `production/` fabrication archives
    - Link `PCB_LAYOUT_GUIDE.md`, `FRONT_PANEL_GUIDE.md`, and `DESIGN_REVIEW.md`
2026-10-21 feat(skills): add agy-brain-explorer skill with updated tool schema support
    - Add `agy-brain-explorer` skill and CLI script for discovering, inspecting, and exporting Antigravity conversation traces
    - Support `Path`, `SearchPath`, and `SearchDirectory` tool arguments as well as `read_file`, `write_file`, and `edit_file` tools for accurate workspace and project detection
    - Fall back to `CommandLine` and `USER_INPUT` path references when inferring session workspaces
2026-10-23 Downsize SMD resistors and decoupling capacitors from 0805 to 0603
    Switch the 100K input pull-down resistors (R1, R5), 470R series output protection resistors (R2-R4, R6-R8), and 100nF op-amp ceramic decoupling capacitors (C3-C6) from 0805 (2012Metric) to 0603 (1608Metric) packages to reduce passive footprint area on the back copper layer.
    Update corresponding JLCPCB Basic Part numbers and MPNs (C14663 / CC0603KRX7R9BB104 for 100nF, C25803 / 0603WAF1003T5E for 100K, and C23179 / 0603WAF4700T5E for 470R), regenerate the KiCad netlist, BOMs, and SVG schematics, and sync project documentation.
    [buffered_multiple_jlcpcb_bom.csv]
2026-10-23 Remove unused SKiDL SVG schematic exports
    Drop `generate_svg()` from `buffered_multiple.py`, delete the generated
    hierarchical `.svg` files, and remove their references from `README.md`
    since the auto-generated SVG diagrams are not useful for the project
    workflow.
2026-10-23 Downsize reverse-polarity protection diodes from SMA to SOD-123
    Switch the power supply protection Schottky diodes (D1, D2) from SS14 in
    SMA (DO-214AC) to B5819W in SOD-123 (LCSC C8598) to reduce PCB footprint
    area by over 50% near the Eurorack power header while retaining a 40V/1A
    rating and JLCPCB Basic Part status.
    Also document 1N5819WS in SOD-323 (LCSC C191023) in component notes and
    layout guides as a drop-in smaller alternative if board space gets tight.
    [buffered_multiple_jlcpcb_bom.csv]
2026-10-23 Add two-stage TVS and series resistor input protection on IN_1 and IN_2
    Protect the Channel 1 and Channel 2 input buffers (TL074H U1A/U2A) against
    ESD strikes and accidental overvoltage patching without degrading 1V/Oct
    pitch CV accuracy or audio bandwidth:
    - Add Nexperia PESD12VL1BA,115 12V bidirectional TVS diodes (D3, D4 in
    SOD-323, LCSC C38558) at each input jack tip to GND. A 12V bidirectional
    standoff passes the full bipolar ±10V Eurorack signal swing without
    clipping, while ultra-low leakage (<50nA max, 1nA typ) and low capacitance
    (19pF) prevent voltage droop on high-impedance CV sources.
    - Add 1K 0603 series resistors (R2, R7, UNI-ROYAL 0603WAF1001T5E, LCSC
    C21190, Basic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
    [buffered_multiple_jlcpcb_bom.csv]
2026-10-23 Update SKiDL skill with compact passive/diode parts and workflow lessons
    Refine the SKiDL skill instructions and JLCPCB BOM reference based on
    findings while downsizing the Buffered Multiple module for a tighter PCB
    layout:
    - Add verified JLCPCB Basic Part numbers for 0603 passives (100nF C14663,
    100K C25803, 470R C23179) and compact 1N5819 Schottky diodes in SOD-123
    (B5819W / C8598, -54% area vs. SMA) and SOD-323 (1N5819WS / C191023,
    -72% area vs. SMA) to save board real estate on narrow Eurorack PCBs
    without incurring Extended Part setup fees.
    - Document using `part.fields["Notes"]` to record fallback packages and
    part numbers so layout alternatives propagate into exported netli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
2026-10-23 Expand buffered multiple to three 1-to-3 channels and downsize D1/D2 to SOD-323
    Increase the module's routing capacity from dual 1-to-3 (1-to-6 cascaded) to
    triple 1-to-3 (1-to-6 / 1-to-9 cascaded) and further compact the power entry
    protection footprint to accommodate the higher component density on a 4HP
    board:
    - Instantiate a third `buffered_channel_1to3` subcircuit (`U3` TL074H, `C7`-`C8`
    100nF decoupling, `D5` PESD12VL1BA TVS, `R11` 100K pull-down, `R12` 1K series
    input protection, `R13`-`R15` 470R output resistors, and `J10`-`J13` jacks).
    - Normal Channel 3's input switch contact (`J10` `TN`) to Channel 2's buffered
    tap (`CH2_BUF`) so unpatched channels cascade cleanly from 1-to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
    [buffered_multiple_jlcpcb_bom.csv]
2026-10-23 Adapt `teach` skill for SKiDL circuit tutorial and standard skill layout
    The `teach` skill was imported from a Rust/`egui` course environment and
    contained legacy frontmatter (`disable-model-invocation`, `argument-hint`),
    `cargo`/`cargo-mutants` instructions, and root-level course paths that
    would conflict with the existing hardware project files in this repo.
    - Update `SKILL.md` frontmatter so Antigravity discovers the skill via
    progressive disclosure and remove legacy `agents/openai.yaml` metadata.
    - Scope all generated course artifacts, runnable lesson apps, and GitHub
    Pages outputs to `./tutorial/` so root hardware design files and
    `README.md` remain untouched.
    - Replace the Rust/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
2026-10-23 Add interactive SKiDL tutorial workspace and initial lessons (0000, 0001)
    Establish a self-contained teaching workspace in `./tutorial/` designed for
    learners who already understand analog/Eurorack electronics (`±12V` rails,
    decoupling, op-amp followers, switched jacks) and want to design and
    manufacture custom Eurorack modules programmatically in Python with SKiDL,
    KiCad 10, and JLCPCB PCBA.
    - Initialize course state (`MISSION.md`, `RESOURCES.md`, `NOTES.md`, and
    learning record `0001`) to focus instruction on Python/SKiDL idioms,
    KiCad 10 symbol/footprint mechanics, and automated BOM metadata rather than
    elementary analog theory.
    - Build Lesson `0000` (`0000-environment-and-kicad-b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
2026-10-24 Complete interactive SKiDL tutorial arc (Lessons 0002–0004), runnable apps, and normalling simulator
    Finish the progressive hardware-as-code curriculum walking through the construction of the 3-channel Eurorack Buffered Multiple from hierarchical subcircuits to fabrication-ready KiCad 10 and JLCPCB PCBA outputs:
    - Add Lesson 0002 (`eurorack_power` `@subcircuit`), Lesson 0003 (`buffered_channel_1to3` single `TL074H` channel), and Lesson 0004 (cascaded `1:3 -> 1:6 -> 1:9` normalling, `NetClass` routing rules, and SMT-filtered JLCPCB BOM export), each backed by retrieval exercises and word-count-balanced quizzes.
    - Provide verified, zero-warning `ERC()` and `ruff`-clean companion scripts and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
    [buffered_multiple_jlcpcb_bom.csv]
2026-10-24 docs(tutorial): inline full Python scripts and grow circuit code from scratch
    Previously, the tutorial lessons referenced line ranges in the root
    `buffered_multiple.py` or companion `tutorial/apps/` files and only
    embedded short excerpts, assuming the reader had another Python file open
    alongside the browser (and creating relative links outside `_site/` that
    would 404 on GitHub Pages).
    Rewrite Lessons 0000–0004 and `tutorial/index.html` so the course starts
    from an empty file in Lesson 0000 and progressively grows the Python
    circuit script step by step across every stage:
    - Present each new code block as it is introduced, followed by the
    complete, standalone, runnable Python script (`bo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
2026-10-24 Refine tutorial lessons and course index to match Brett Morgan's writing voice
    The initial tutorial lessons read like a formal textbook rather than a seasoned software engineer exploring Eurorack hardware-as-code. Rewrite the lesson openings, hardware explanations, and SKiDL gotchas across the course index and Lessons 0000–0004 to reflect Brett Morgan's conversational cadence, grounded analogies ("bleep-bloop music", "letting the magic smoke escape", 1V/Oct pitch droop), and pragmatic focus on software engineering hygiene (`uv`, `ruff`, and deterministic `ERC()`).
    Also standardise prose on Australian English spelling (`initialises`, `energised`, `catalogue`, `centre`, `polarised`, `alumin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
2026-10-24 Refine tutorial lessons and references for authentic writing voice and Australian English
    Update the interactive SKiDL course lessons, index, and reference sheets so the prose reads like a software engineer exploring Eurorack hardware rather than an impersonal textbook:
    - Frame technical gotchas (pre-import KiCad 10 environment variables, `part.fields["LCSC"]` vs attribute assignment, bipolar `-12V` diode/capacitor polarity, `for`-loop output stages, and `builtins.NC` ordering) around real-world discoveries and software engineering hygiene (`ruff`, `ERC()`).
    - Credit Dave Vandenbout (`devbisme`) for creating SKiDL in Lesson 0000.
    - Standardise prose and quiz explanations on Australian Engli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
2026-10-24 Add post-netlist lessons (0005-0007) and switch tutorial index to a 2-wide card grid
    The original 5-lesson tutorial (0000-0004) stopped after generating `buffered_multiple.py` and left an uneven 5-card grid on the course landing page. To complete the hardware-as-code lifecycle from exported netlist to manufactured Eurorack module—and balance the landing page layout—this commit adds three post-netlist lessons backed by runnable, Ruff-clean Python scripts and switches `.lesson-grid` to a 2-column layout (4 rows of 2 lesson cards and 2 rows of 2 reference cards):
    - Lesson 0005 (`0005-kicad-pcb-layout-and-assembly`): Explains how SKiDL's hierarchical `tag` strings map to deterministic `(tst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
    [BufferedMult_Panel_3Ch.kicad_pcb, buffered_multiple_jlcpcb_bom.csv, layout_placement_plan.csv]
2026-10-24 Refine Lessons 0004–0007 and glossary for writing voice and Australian English
    Update the post-netlist lessons (0005–0007), Lesson 0004's transition callout,
    and the hardware glossary so the prose matches Brett Morgan's authentic
    first-person writing voice rather than reading like a detached technical manual:
    - Frame hardware and CAD gotchas—such as deterministic SKiDL `tstamps` during
    `pcbnew` re-imports, the +6.48 mm Thonkiconn bushing offset, and the 9 layout
    issues caught by `kicad-cli pcb drc`—around real-world false starts and
    conversational pivots ("Turns out,", "Which leads me to...").
    - Standardise prose and quiz explanations on Australian English spelling
    (millimet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
2026-10-24 Add `tutorial-pipeline` workspace skill for local Markdown-to-HTML builds
    Provide a reusable agent runbook and CLI wrapper (`.agents/skills/tutorial-pipeline/`) for compiling, validating, staging, and previewing the Markdown-authored course in `tutorial/`.
    - Add `SKILL.md` with step-by-step instructions for running `tutorial/build.py --check`, staging the GitHub Pages `_site/` bundle, serving a local preview, and resolving frontmatter or equal-word-count quiz validation errors.
    - Add `scripts/dev_pipeline.sh` to streamline `build`, `stage`, `serve`, and `clean` operations using the workspace `.venv` and `ruff`.
    - Add `references/DIRECTIVES.md` for progressive disclosure of YAML frontmatter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
2026-10-24 New layout
    [BufferedMult.kicad_pcb]
2026-10-24 Review 3-channel PCB layout and regenerate mated 4HP panel and production files
    Following the expansion of BufferedMult.kicad_pcb to the full three-channel (1:3 / 1:6 / 1:9) 44-component layout, synchronize the front panel design, fabrication outputs, and design review documentation:
    - Update generate_eurorack_panel.py to handle uniform 6-row (14.40 mm pitch) jack grids by placing front silkscreen labels at inter-row midpoints and positioning rear silkscreen text below the lowest jack row to prevent silkscreen overlap and solder-mask clipping.
    - Regenerate BufferedMult_Panel.kicad_pcb and production/BufferedMult_Panel.zip (plus production/panel/ Gerbers and drills) with 12 grounded 6.2 mm j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
    [BufferedMult_Panel-B_Cu.gbl, BufferedMult_Panel-B_Mask.gbs, BufferedMult_Panel-B_Paste.gbp, BufferedMult_Panel-B_Silkscreen.gbo, BufferedMult_Panel-Edge_Cuts.gm1, BufferedMult_Panel-F_Cu.gtl, BufferedMult_Panel-F_Mask.gts, BufferedMult_Panel-F_Paste.gtp]
2026-10-24 Add labels and rebuild gerbers
    [BufferedMult.kicad_pcb, BufferedMult_Panel.kicad_pcb, bom.csv, designators.csv, positions.csv]
2026-10-24 Update DESIGN_REVIEW.md after silkscreen label additions and Gerber rebuild
    Record the verification of the `-12V` power header orientation callout, `V2.0` revision marking, and repository URL on `B.SilkS`, along with the rebuilt main PCB and front panel Gerber archives (`161f9ae`), confirming zero remaining pre-fabrication action items.
2026-10-24 Tidy up PCBs
    [BufferedMult.kicad_pcb, BufferedMult_Panel.kicad_pcb]
2026-10-24 Regenerate panel production files
    [BufferedMult_Panel.kicad_pcb, designators.csv]
2026-10-24 Regenerate main board production files
    [BufferedMult.kicad_pcb, designators.csv]
2026-10-24 Update README for V2.0 3-channel PCB layout and link GitHub Pages tutorial
    Align the project documentation with the completed 3-channel (44-component, 20.0 x 109.0 mm) main PCB revision and mated 4HP front panel, and surface direct links to the published GitHub Pages interactive tutorial (https://domesticmouse.github.io/BufferedMult-SKiDL/) so readers can access the hosted course without building it locally.
2026-10-25 Hero image of the v2 PCB
2026-10-28 Renumber tutorial lessons and companion apps from 0000–0007 to 0001–0008
    Shift the tutorial progression to 1-based numbering so the first lesson starts at 0001 (Stage 1) instead of 0000 (Stage 0), aligning lesson IDs, runnable app directories, navigation links, Mermaid progression diagrams, reference sheets, and pipeline documentation across the course.
    [BufferedMult_Panel_3Ch.kicad_pcb, buffered_multiple_jlcpcb_bom.csv, layout_placement_plan.csv]
2026-10-28 Document the 8-lesson tutorial progression and reference sheets in README
    Add a dedicated tutorial overview table mapping Lessons 0001–0008 (Stages 1–8) to their Markdown sources and runnable companion Python apps, list the four printable reference sheets in `tutorial/reference/`, and include `markdown-it-py` and `pyyaml` in the virtual environment setup instructions so `tutorial/build.py` runs out of the box.
2026-10-29 Add GitHub repository link to the tutorial site footer
    The tutorial previously had no link back to its underlying source repository (`domesticmouse/BufferedMult-SKiDL`), making it difficult for readers browsing the rendered site to locate the project source code, scripts, and KiCad files. Add a direct link to the GitHub repository in the shared `.site-footer` template in `tutorial/build.py` so every generated tutorial page links back to the repo.
